Ariamelon/Ariamelon-Kicad-Master-Library/README.md

# Ariamelon Kicad Master Library
 Aria's Kicad Master Library
