Ariamelon/Ariamelon-Kicad-Master-Library/Ariamelon-Breakout-3D/Breakout_Raytac_MDBT50Q-U1MV2.STEP

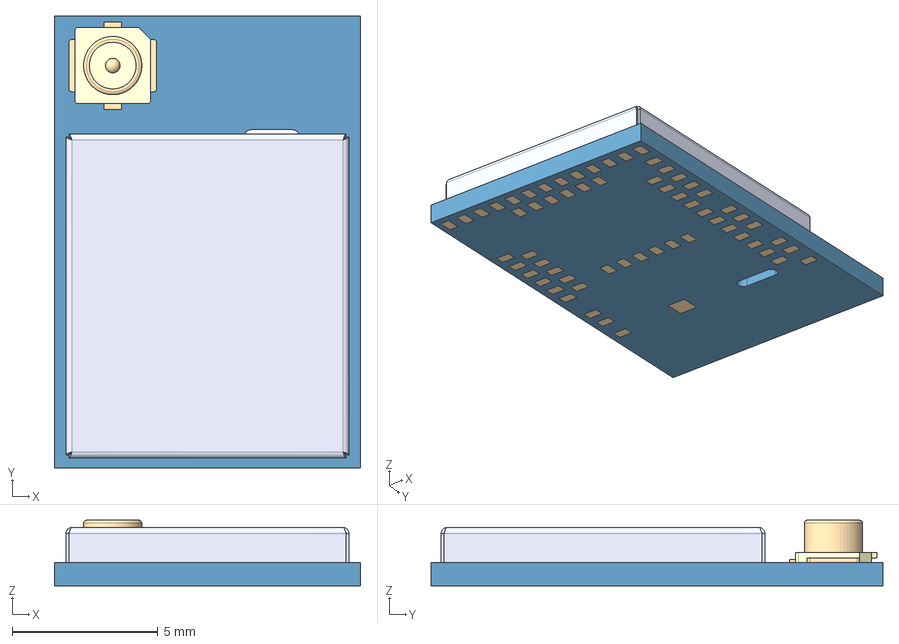
[picture p1: CAD file, 2023-08-23]
Ariamelon-Breakout-3D/Breakout_Raytac_MDBT50Q-U1MV2.STEP
10.5 x 15.5 x 2.25 mm
