Ariamelon/Ariamelon-Kicad-Master-Library/Ariamelon-Connector-3D/JST_SH_SM03B-SRSS-TB_1x03-1MP_P1.00mm_Horizontal.STEP

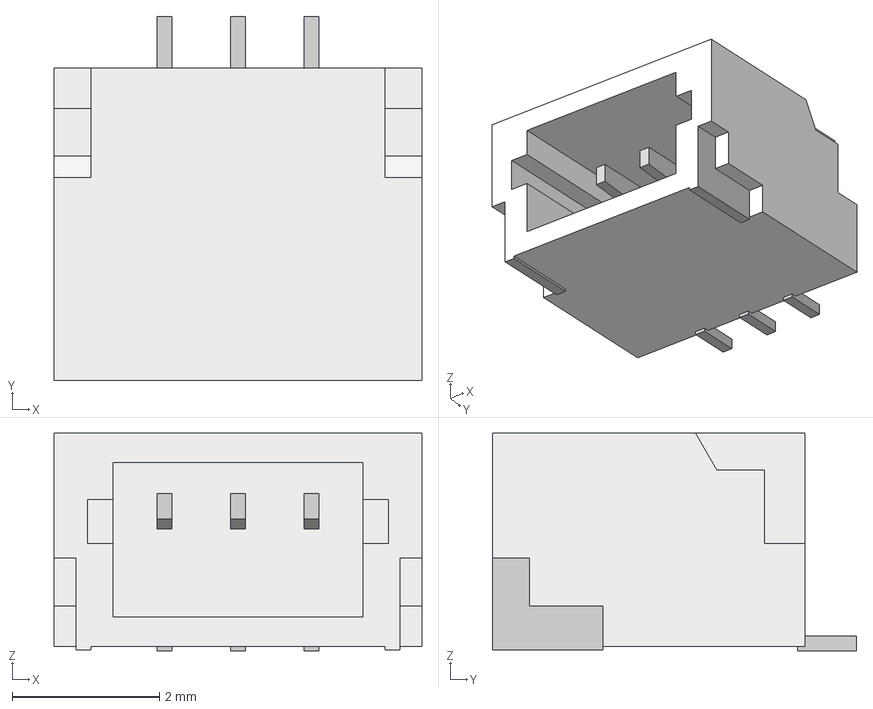
[picture p2: CAD file, 2023-08-23]
Ariamelon-Connector-3D/JST_SH_SM03B-SRSS-TB_1x03-1MP_P1.00mm_Horizontal.STEP
5.00 x 4.95 x 2.96 mm
