Ariamelon/Ariamelon-Kicad-Master-Library/Ariamelon-Device-3D/L_Murata_786J.STEP

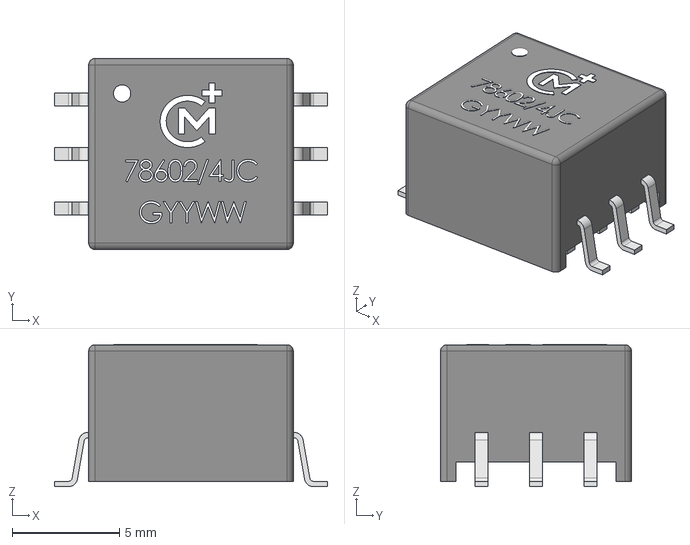
[picture p3: CAD file, 2023-09-18]
Ariamelon-Device-3D/L_Murata_786J.STEP
12.7 x 8.89 x 6.62 mm
