Ariamelon/Ariamelon-Kicad-Master-Library/Ariamelon-Misc-3D/Heatsink_CUI_HSE-B20380-040H.step

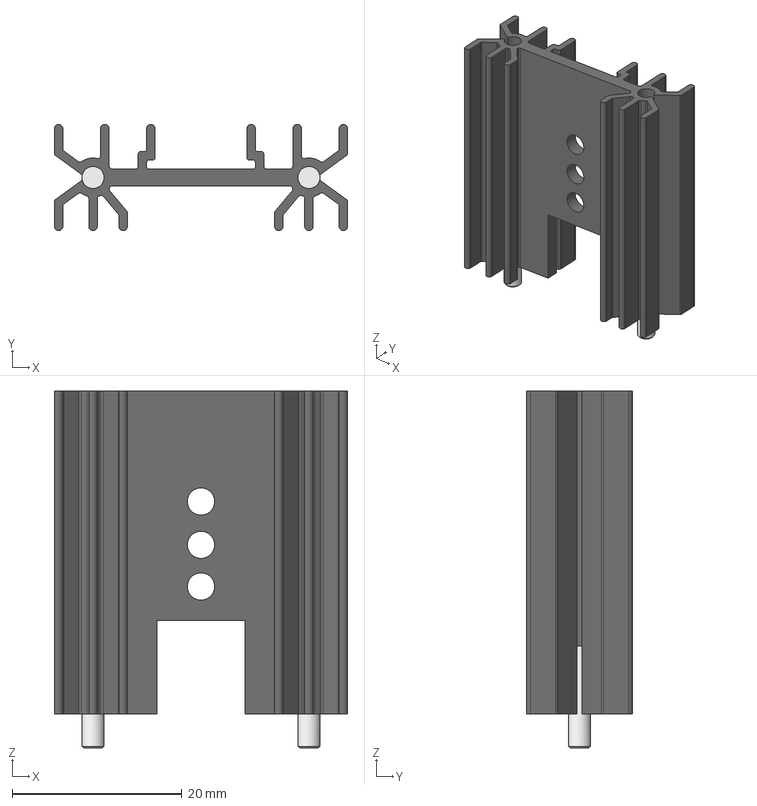
[picture p4: CAD file, 2023-09-23]
Ariamelon-Misc-3D/Heatsink_CUI_HSE-B20380-040H.step
34.5 x 12.5 x 42.0 mm
