Ariamelon/Ariamelon-Kicad-Master-Library/Ariamelon-RotaryEncoder-3D/RotaryEncoder_Alps_EC11E_Vertical_H20mm.step

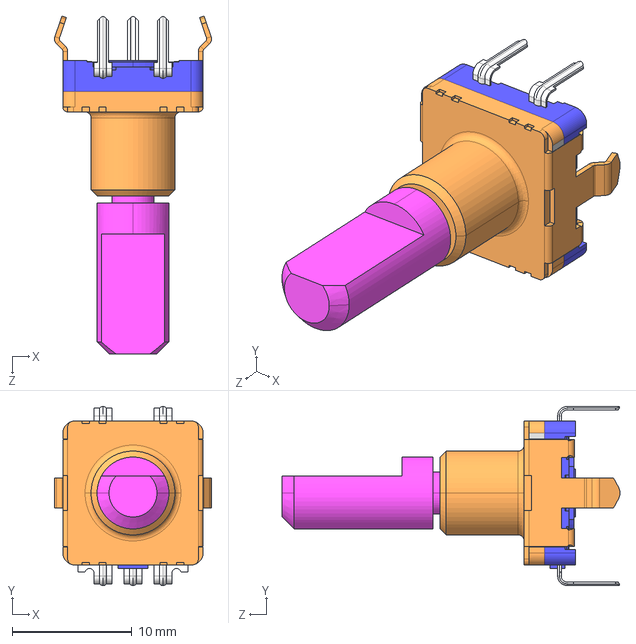
[picture p5: CAD file, 2023-08-24]
Ariamelon-RotaryEncoder-3D/RotaryEncoder_Alps_EC11E_Vertical_H20mm.step
13.1 x 15.0 x 28.2 mm
