Ariamelon/Ariamelon-Kicad-Master-Library/Ariamelon-Switch-3D/SW_KS33_Hotswap-Socket.step

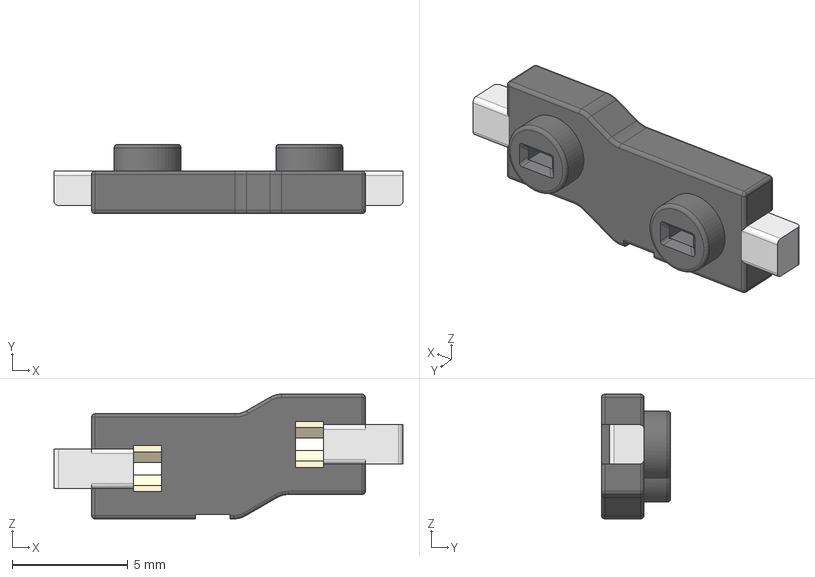
[picture p6: CAD file, 2024-10-16]
Ariamelon-Switch-3D/SW_KS33_Hotswap-Socket.step
15.1 x 3.00 x 5.40 mm
