Ariamelon/Ariamelon-Kicad-Master-Library/Ariamelon-Connector-3D/Hirose_CX70M-24P1.step

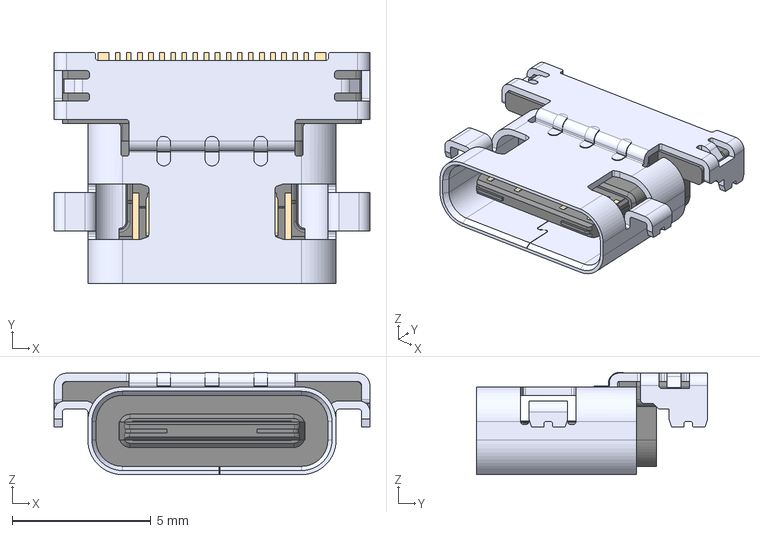
[picture p8: CAD file, 2023-08-23]
Ariamelon-Connector-3D/Hirose_CX70M-24P1.step
11.4 x 8.35 x 3.69 mm
