Ariamelon/Ariamelon-Kicad-Master-Library/Ariamelon-Device-3D/Fuse_1812_4532Metric.STEP

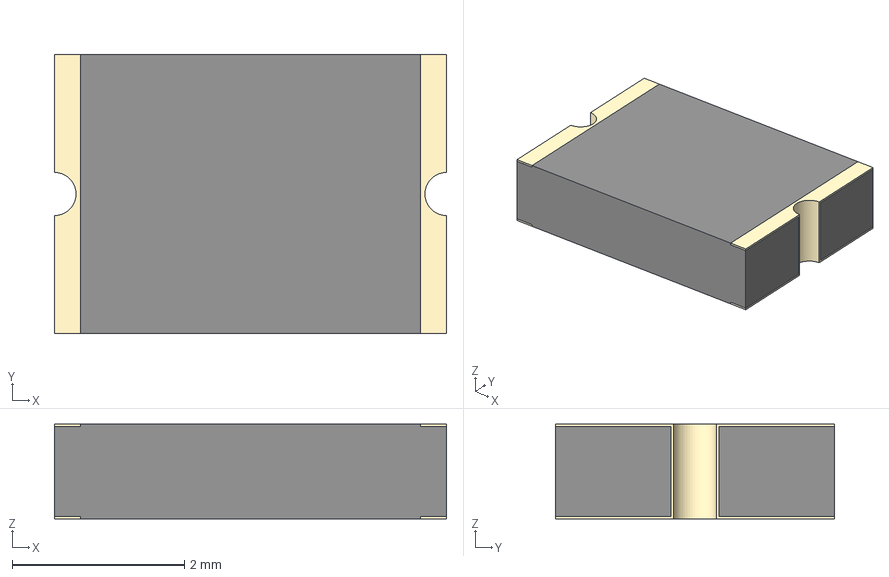
[picture p9: CAD file, 2023-09-18]
Ariamelon-Device-3D/Fuse_1812_4532Metric.STEP
4.55 x 3.24 x 1.10 mm
