Ariamelon/Ariamelon-Kicad-Master-Library/Ariamelon-Misc-3D/Heatsink_Fischer_SK104-STC-STIC_35x13mm_2xDrill2.5mm.step

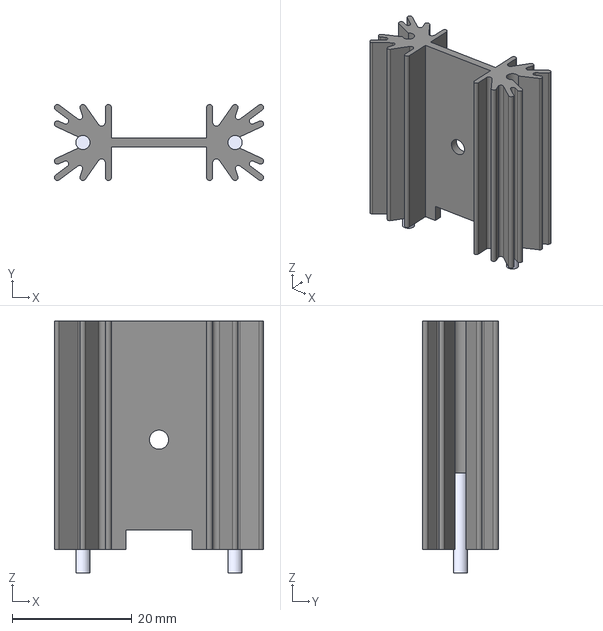
[picture p10: CAD file, 2023-09-22]
Ariamelon-Misc-3D/Heatsink_Fischer_SK104-STC-STIC_35x13mm_2xDrill2.5mm.step
34.9 x 12.7 x 42.1 mm
