Ariamelon/Ariamelon-Kicad-Master-Library/Ariamelon-Package-3D/SOP-8-Advance_5.0x6.0mm_P1.27mm.step

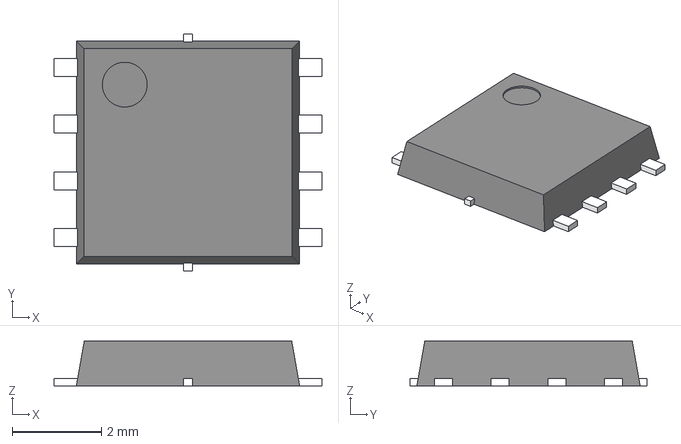
[picture p11: CAD file, 2023-10-16]
Ariamelon-Package-3D/SOP-8-Advance_5.0x6.0mm_P1.27mm.step
6.00 x 5.30 x 1.00 mm
