Ariamelon/Ariamelon-Kicad-Master-Library/Ariamelon-RotaryEncoder-3D/RotaryEncoder_Bourns_PER601-P117-N0015.stp

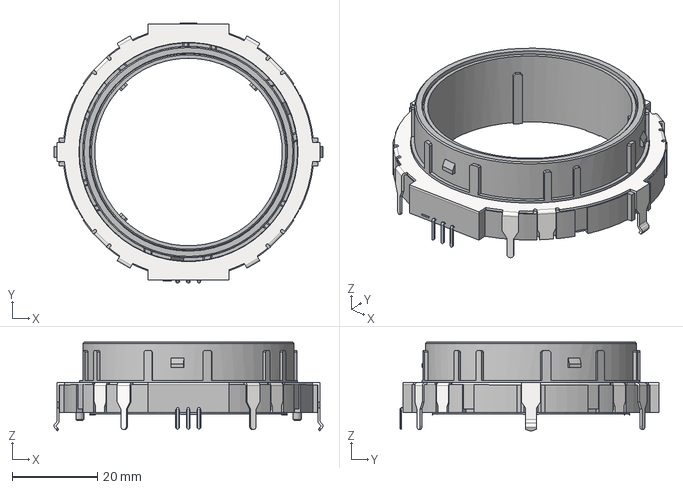
[picture p12: CAD file, 2023-08-23]
Ariamelon-RotaryEncoder-3D/RotaryEncoder_Bourns_PER601-P117-N0015.stp
63.1 x 61.1 x 20.8 mm
