Ariamelon/Ariamelon-Kicad-Master-Library/Ariamelon-Switch-3D/SW_Cap_Choc_LP_1U.step

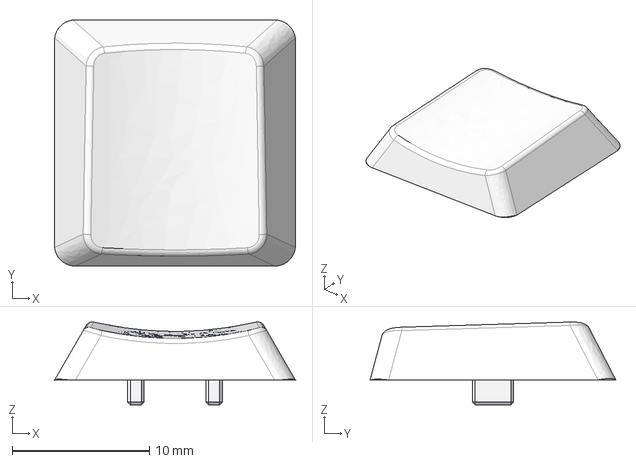
[picture p13: CAD file, 2023-08-27]
Ariamelon-Switch-3D/SW_Cap_Choc_LP_1U.step
17.5 x 17.9 x 6.03 mm
