Ariamelon/Ariamelon-Kicad-Master-Library/Ariamelon-Breakout-3D/Breakout_OLED_1.5_SSD1351_128x128.step

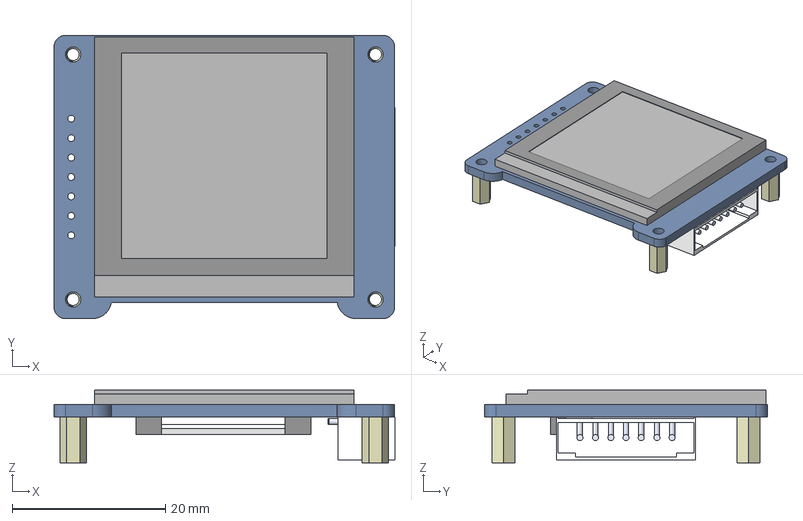
[picture p14: CAD file, 2023-08-23]
Ariamelon-Breakout-3D/Breakout_OLED_1.5_SSD1351_128x128.step
44.5 x 37.0 x 9.50 mm
M2XH6_COPPER-POST x 4
1_5INCH_OLED_RGB_PCBA
1_5INCH-RGB-OLED
