Ariamelon/Ariamelon-Kicad-Master-Library/Ariamelon-Connector-3D/Hirose_FH34SRJ-20S-0.5SH(50).step

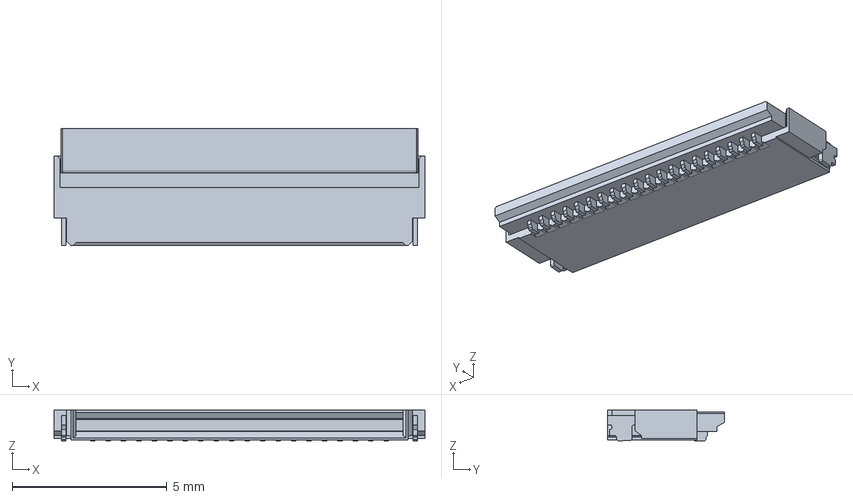
[picture p15: CAD file, 2023-08-23]
Ariamelon-Connector-3D/Hirose_FH34SRJ-20S-0.5SH(50).step
12.0 x 3.80 x 1.00 mm
