Ariamelon/Ariamelon-Kicad-Master-Library/Ariamelon-Device-3D/Crystal_SMD_2012-2Pin_2.0x1.2mm.STEP

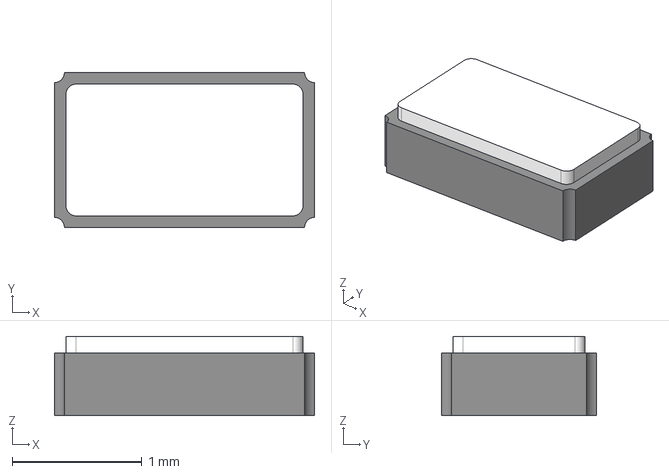
[picture p16: CAD file, 2023-08-23]
Ariamelon-Device-3D/Crystal_SMD_2012-2Pin_2.0x1.2mm.STEP
2.01 x 1.19 x 0.612 mm
