Ariamelon/Ariamelon-Kicad-Master-Library/Ariamelon-Misc-3D/Relay_Panasonic_CB1-P-12V.step

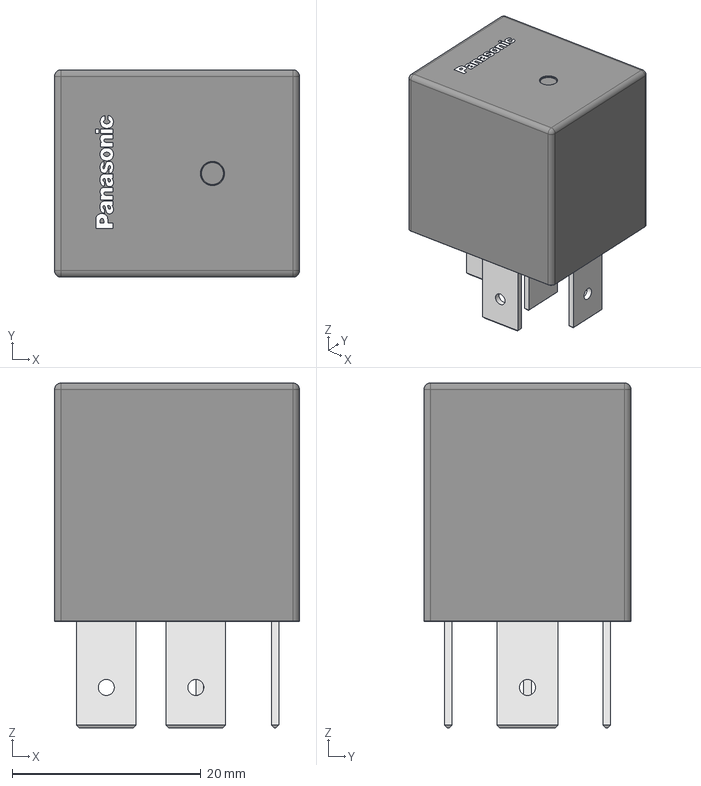
[picture p17: CAD file, 2023-08-23]
Ariamelon-Misc-3D/Relay_Panasonic_CB1-P-12V.step
26.0 x 22.0 x 36.6 mm
terminals
logo
