Ariamelon/Ariamelon-Kicad-Master-Library/Ariamelon-Package-3D/USON-8-1EP_3x2mm_P0.5mm_EP1.6x0.2mm.stp

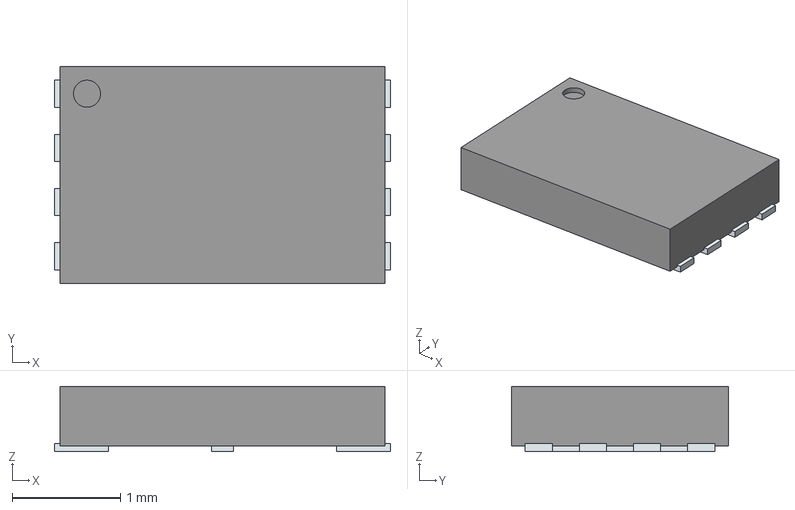
[picture p18: CAD file, 2023-08-23]
Ariamelon-Package-3D/USON-8-1EP_3x2mm_P0.5mm_EP1.6x0.2mm.stp
3.10 x 2.00 x 0.6 mm
ThermalPin
PinsArrayLR
