Ariamelon/Ariamelon-Kicad-Master-Library/Ariamelon-Switch-3D/SW_Cherry_MX_PCB.STEP

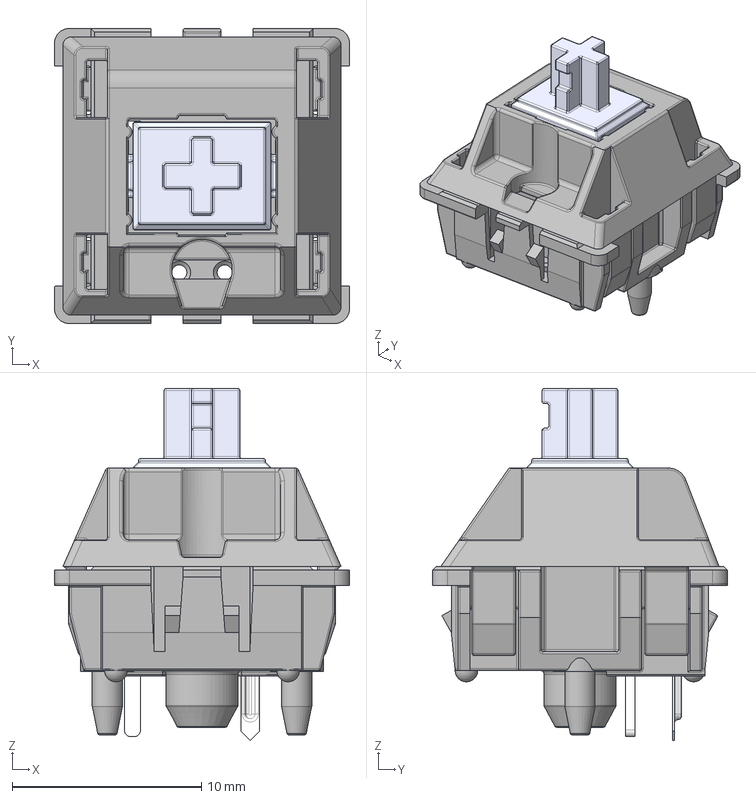
[picture p20: CAD file, 2023-08-23]
Ariamelon-Switch-3D/SW_Cherry_MX_PCB.STEP
15.6 x 15.6 x 18.6 mm
Pins
Top Housing
Stem
Bottom Housing
