Ariamelon/Ariamelon-Kicad-Master-Library/Ariamelon-Breakout-3D/Breakout_Raytac_MDBT50Q-1MV2.step

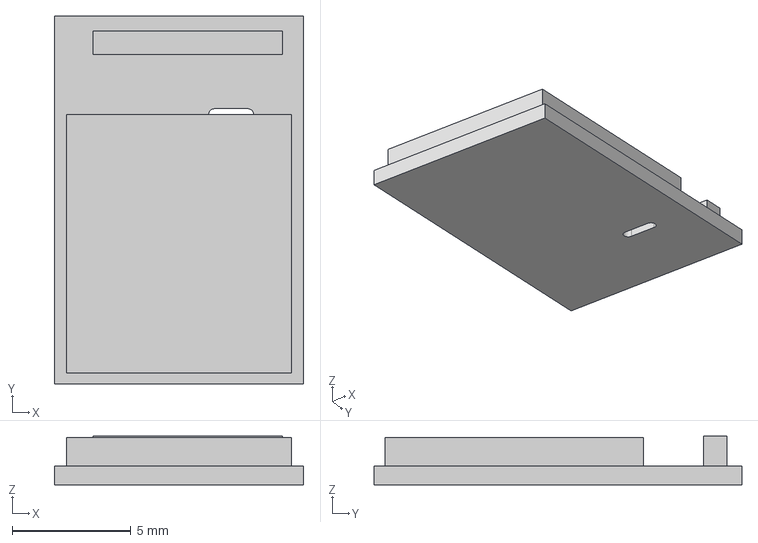
[picture p21: CAD file, 2023-08-23]
Ariamelon-Breakout-3D/Breakout_Raytac_MDBT50Q-1MV2.step
10.5 x 15.5 x 2.05 mm
