Ariamelon/Ariamelon-Kicad-Master-Library/Ariamelon-Device-3D/L_Murata_LQH3NPZ.step

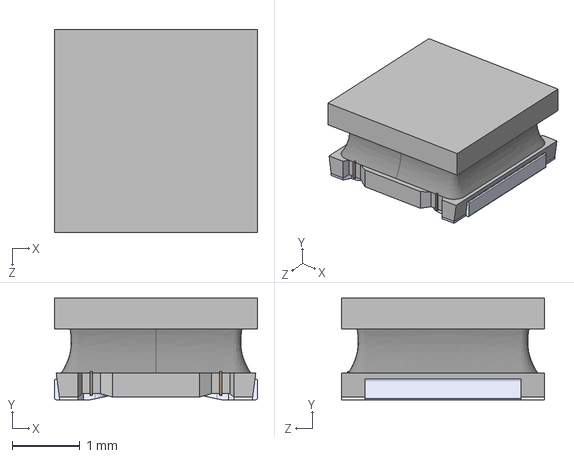
[picture p23: CAD file, 2023-08-23]
Ariamelon-Device-3D/L_Murata_LQH3NPZ.step
3.00 x 1.50 x 3.00 mm
