Ariamelon/Ariamelon-Kicad-Master-Library/Ariamelon-Package-3D/PixArt_PMW3360DM-T2QU.step

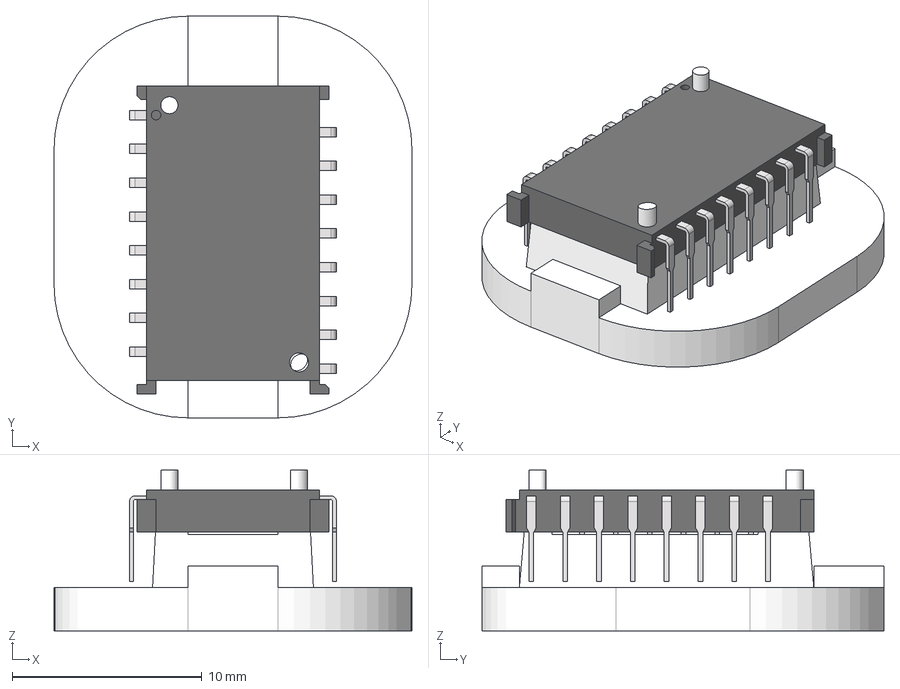
[picture p24: CAD file, 2023-08-23]
Ariamelon-Package-3D/PixArt_PMW3360DM-T2QU.step
18.9 x 21.1 x 8.46 mm
Lead x 8
Lead(Mirror) x 8
Lens
