Ariamelon/Ariamelon-Kicad-Master-Library/Ariamelon-RotaryEncoder-3D/RotaryEncoder_Panasonic_EVQVVD00203B.step

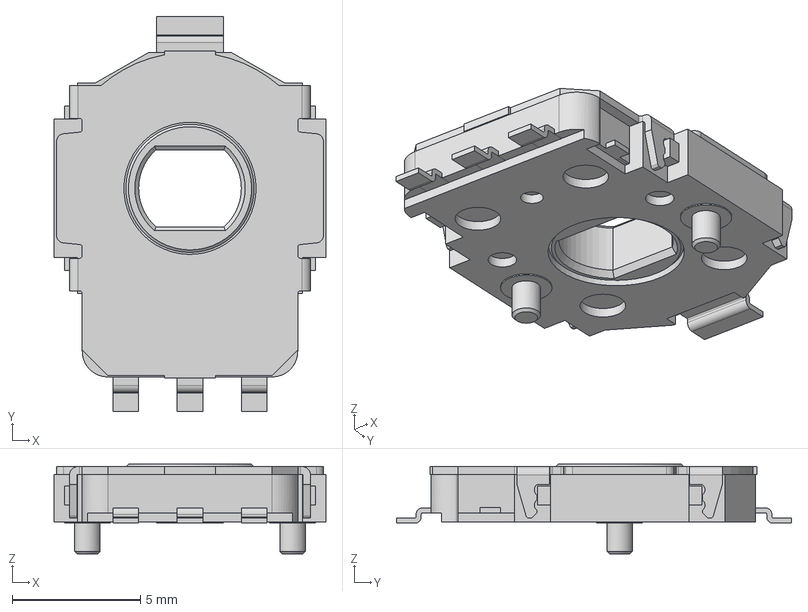
[picture p25: CAD file, 2023-08-23]
Ariamelon-RotaryEncoder-3D/RotaryEncoder_Panasonic_EVQVVD00203B.step
10.6 x 15.4 x 3.50 mm
