Ariamelon/Ariamelon-Kicad-Master-Library/Ariamelon-Switch-3D/SW_Panasonic_EVQPUL_EVQPUC.step

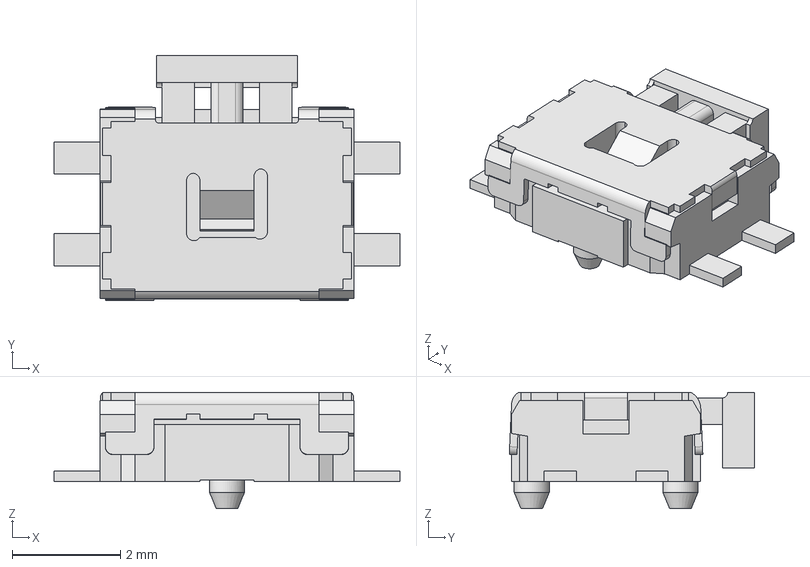
[picture p26: CAD file, 2023-08-23]
Ariamelon-Switch-3D/SW_Panasonic_EVQPUL_EVQPUC.step
6.40 x 4.54 x 2.15 mm
