Ariamelon/Ariamelon-Kicad-Master-Library/Ariamelon-Breakout-3D/Breakout_Ebyte_E73-2G4M08S1C.step

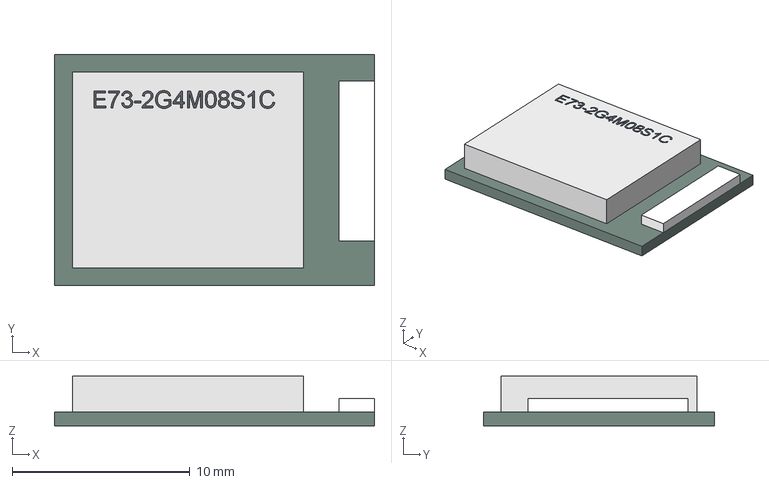
[picture p27: CAD file, 2023-08-23]
Ariamelon-Breakout-3D/Breakout_Ebyte_E73-2G4M08S1C.step
18.0 x 13.0 x 2.81 mm
