Ariamelon/Ariamelon-Kicad-Master-Library/Ariamelon-Connector-3D/HRO_TYPE-C-31-M-14.step

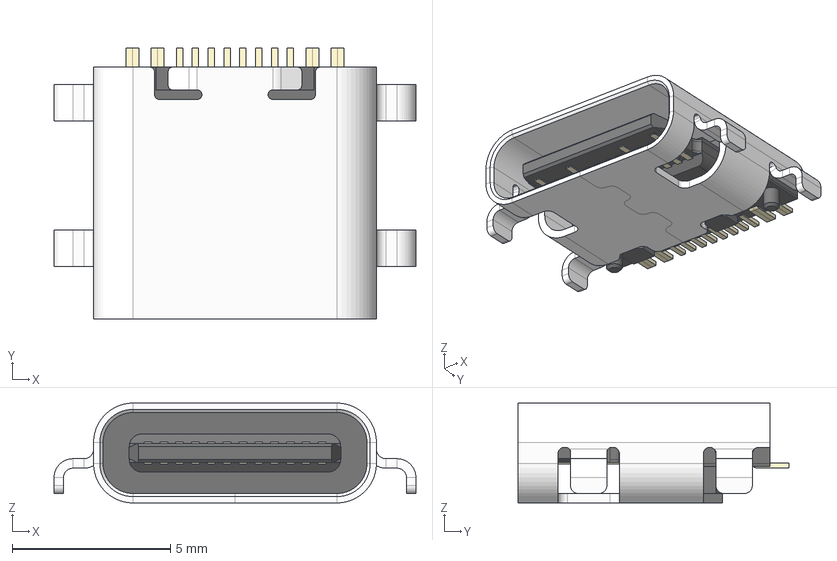
[picture p28: CAD file, 2023-08-23]
Ariamelon-Connector-3D/HRO_TYPE-C-31-M-14.step
11.5 x 8.56 x 3.16 mm
Shroud
Plastic Body & Connector
