Ariamelon/Ariamelon-Kicad-Master-Library/Ariamelon-Device-3D/L_Murata_DFE201610P.STEP

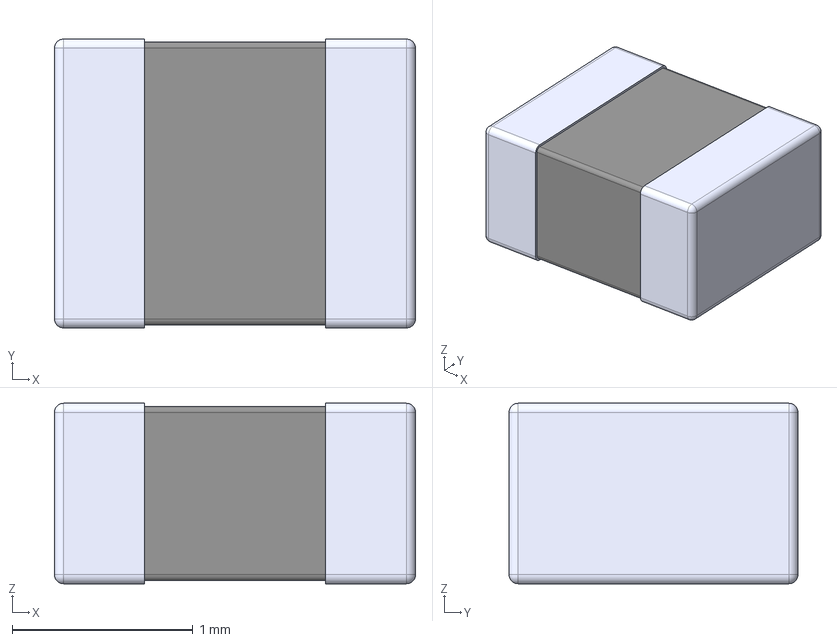
[picture p29: CAD file, 2023-08-23]
Ariamelon-Device-3D/L_Murata_DFE201610P.STEP
2.00 x 1.60 x 1.00 mm
