Ariamelon/Ariamelon-Kicad-Master-Library/Ariamelon-Package-3D/Diodes_PowerDI3333-8.STEP

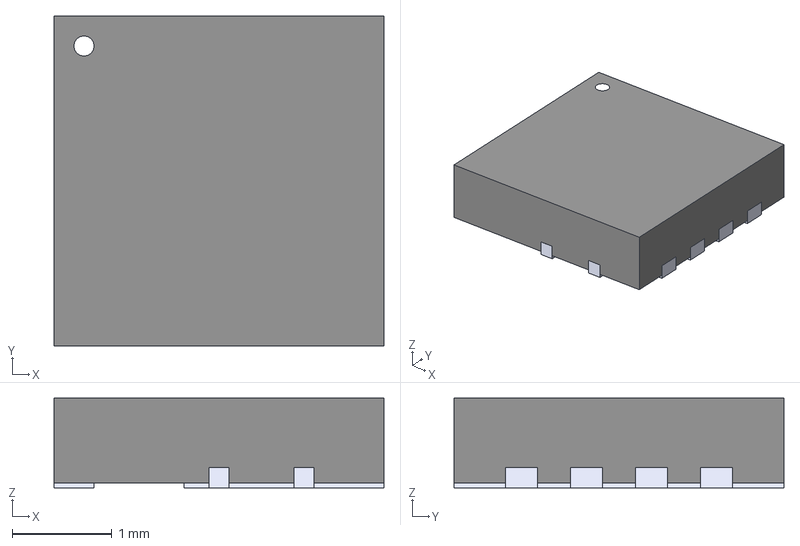
[picture p30: CAD file, 2023-08-23]
Ariamelon-Package-3D/Diodes_PowerDI3333-8.STEP
3.30 x 3.30 x 0.9 mm
