Ariamelon/Ariamelon-Kicad-Master-Library/Ariamelon-RotaryEncoder-3D/RotaryEncoder_Alps_EC10E-9MM.step

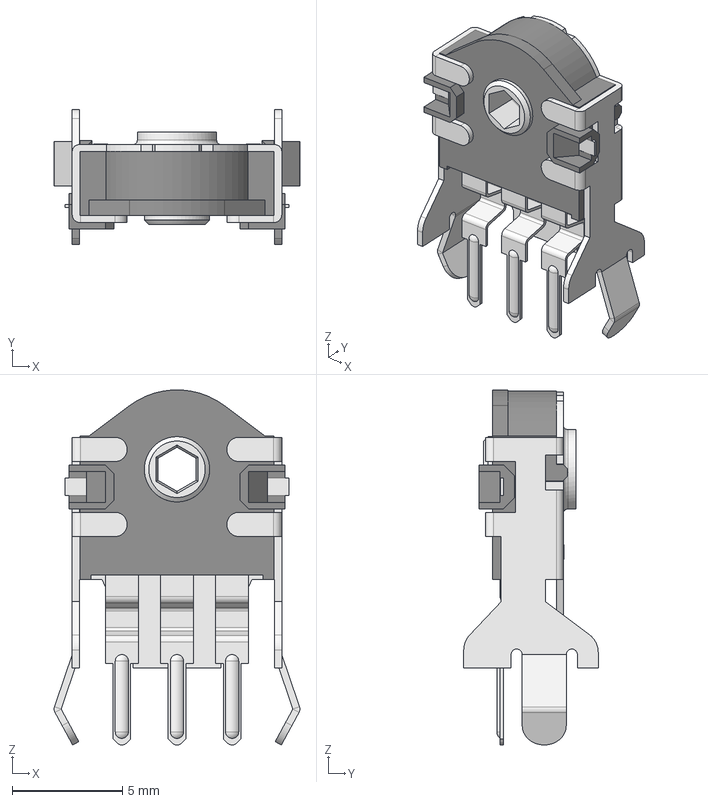
[picture p31: CAD file, 2023-08-23]
Ariamelon-RotaryEncoder-3D/RotaryEncoder_Alps_EC10E-9MM.step
11.1 x 6.10 x 16.1 mm
