Ariamelon/Ariamelon-Kicad-Master-Library/Ariamelon-Switch-3D/SW_Kailh_Hotswap-Socket_MX.step

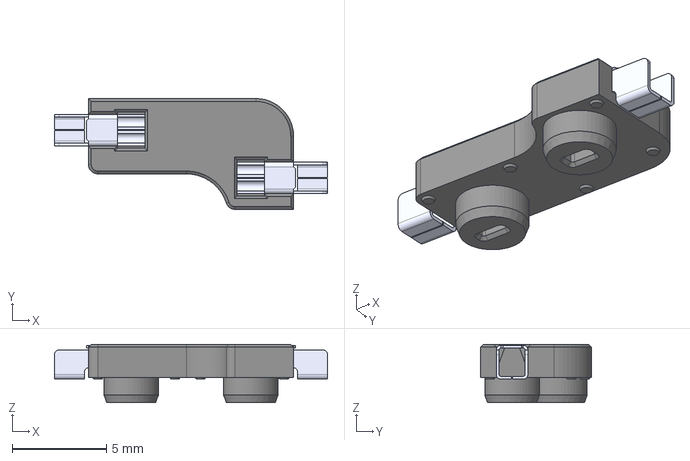
[picture p32: CAD file, 2023-08-23]
Ariamelon-Switch-3D/SW_Kailh_Hotswap-Socket_MX.step
14.5 x 5.89 x 3.10 mm
