Ariamelon/Ariamelon-Kicad-Master-Library/Ariamelon-Connector-3D/GCT_USB4120-03-C-REVA.step

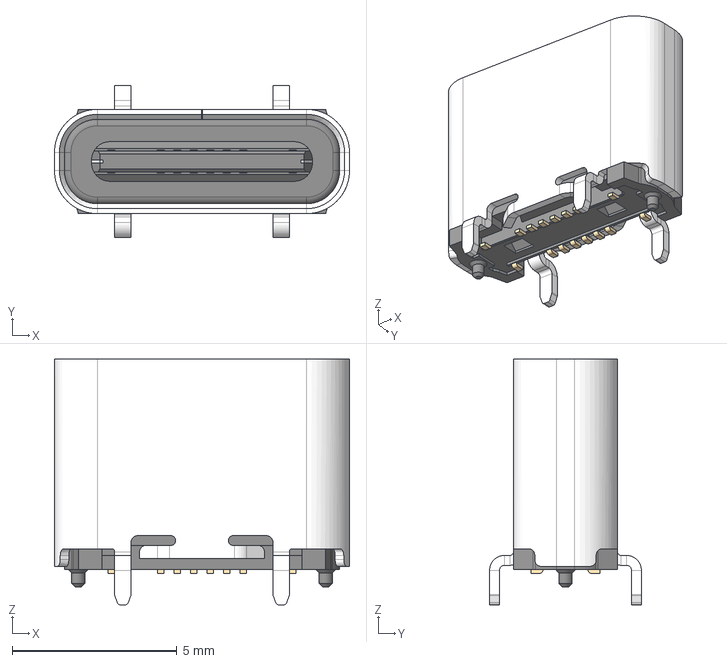
[picture p33: CAD file, 2023-08-23]
Ariamelon-Connector-3D/GCT_USB4120-03-C-REVA.step
8.94 x 4.60 x 7.45 mm
