Ariamelon/Ariamelon-Kicad-Master-Library/Ariamelon-Device-3D/Crystal_SMD_3215-2Pin_3.2x1.5mm.STEP

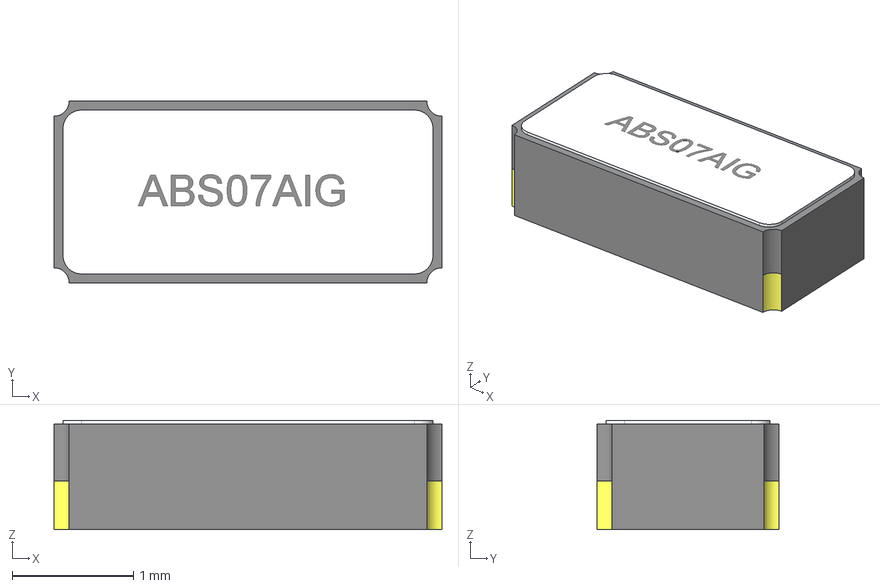
[picture p34: CAD file, 2023-08-23]
Ariamelon-Device-3D/Crystal_SMD_3215-2Pin_3.2x1.5mm.STEP
3.20 x 1.50 x 0.901 mm
