Ariamelon/Ariamelon-Kicad-Master-Library/Ariamelon-Package-3D/Texas_R-PUQFN-N10.step

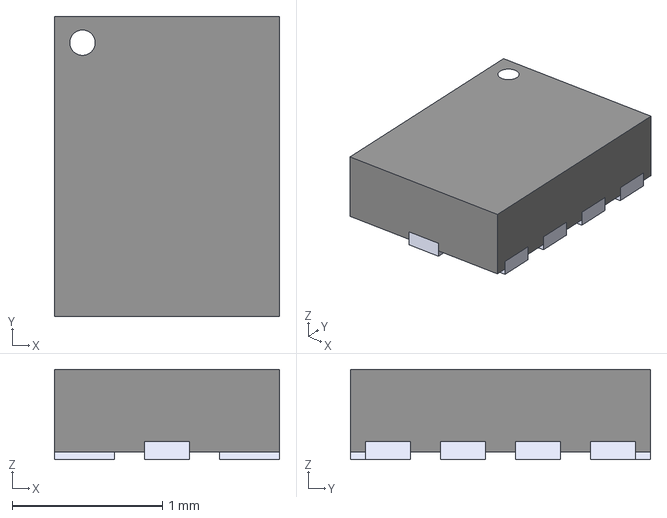
[picture p35: CAD file, 2023-08-23]
Ariamelon-Package-3D/Texas_R-PUQFN-N10.step
1.50 x 2.00 x 0.6 mm
