Ariamelon/Ariamelon-Kicad-Master-Library/Ariamelon-RotaryEncoder-3D/RotaryEncoder_Alps_EC10E.step

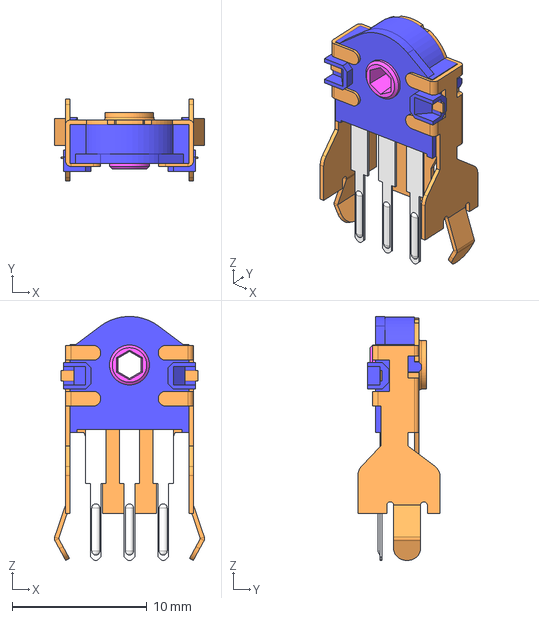
[picture p36: CAD file, 2023-08-23]
Ariamelon-RotaryEncoder-3D/RotaryEncoder_Alps_EC10E.step
11.1 x 6.10 x 18.1 mm
