Ariamelon/Ariamelon-Kicad-Master-Library/Ariamelon-Switch-3D/SW_Kailh_Choc.step

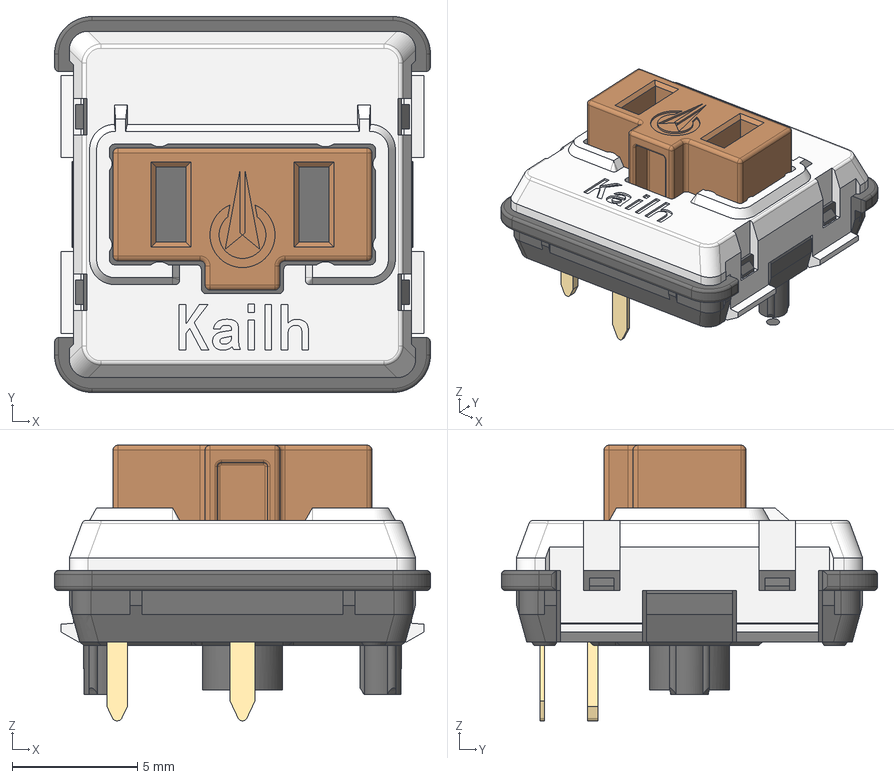
[picture p37: CAD file, 2023-08-23]
Ariamelon-Switch-3D/SW_Kailh_Choc.step
15.0 x 15.0 x 11.0 mm
