Ariamelon/Ariamelon-Kicad-Master-Library/Ariamelon-Device-3D/Crystal_SMD_2016-4Pin_2.0x1.6mm.STEP

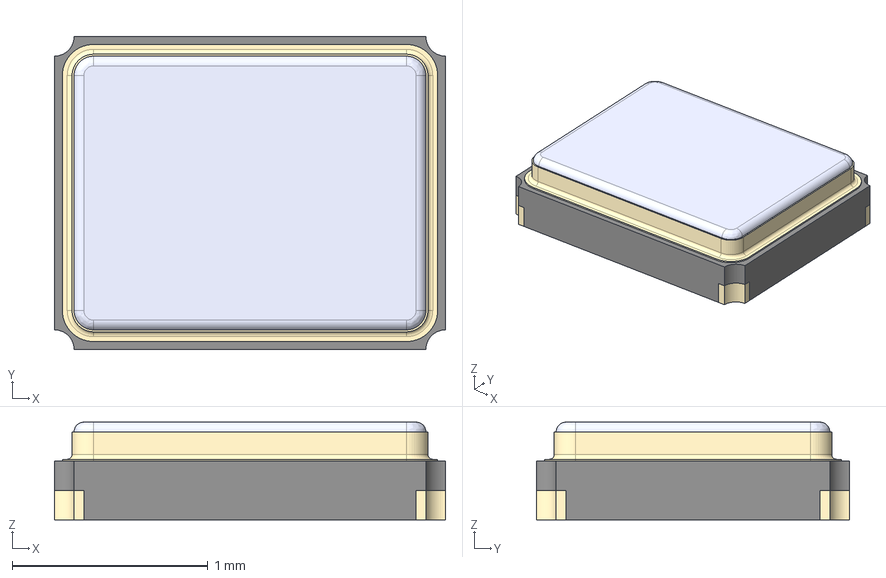
[picture p39: CAD file, 2023-08-23]
Ariamelon-Device-3D/Crystal_SMD_2016-4Pin_2.0x1.6mm.STEP
2.00 x 1.60 x 0.5 mm
