Ariamelon/Ariamelon-Kicad-Master-Library/Ariamelon-Package-3D/WSON-8-1EP_2x2mm_P0.5mm_EP0.9x1.6mm.stp

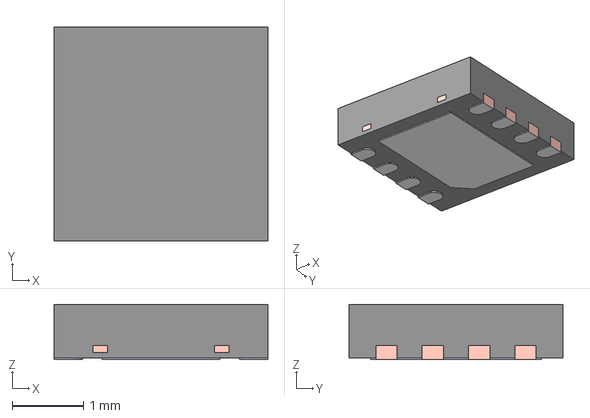
[picture p40: CAD file, 2023-08-23]
Ariamelon-Package-3D/WSON-8-1EP_2x2mm_P0.5mm_EP0.9x1.6mm.stp
3.00 x 3.00 x 0.775 mm
BODY-SON
FRAME-DRB0008B
