Ariamelon/Ariamelon-Kicad-Master-Library/Ariamelon-Switch-3D/SW_Cap_DSA_2.75U.step

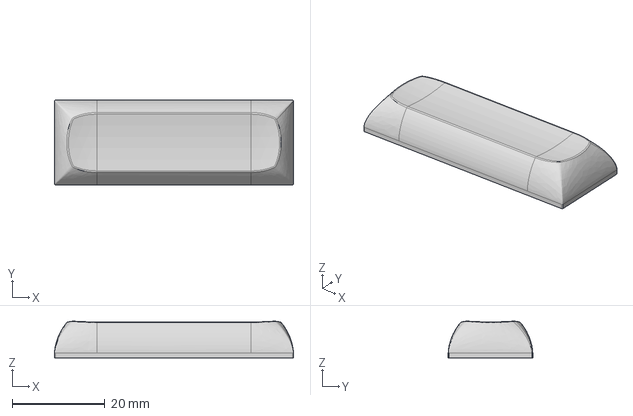
[picture p41: CAD file, 2023-08-23]
Ariamelon-Switch-3D/SW_Cap_DSA_2.75U.step
51.5 x 18.2 x 7.91 mm
