Ariamelon/Ariamelon-Kicad-Master-Library/Ariamelon-Connector-3D/JST_SH_SM02B-SRSS-TB_1x02-1MP_P1.00mm_Horizontal.STEP

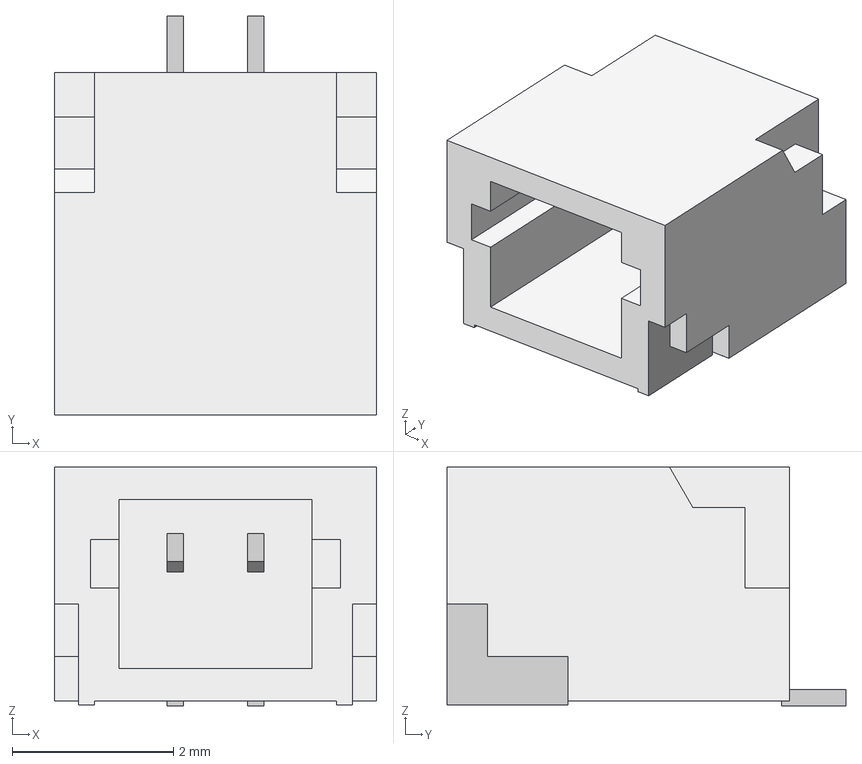
[picture p42: CAD file, 2023-08-23]
Ariamelon-Connector-3D/JST_SH_SM02B-SRSS-TB_1x02-1MP_P1.00mm_Horizontal.STEP
4.00 x 4.95 x 2.96 mm
