Ariamelon/Ariamelon-Kicad-Master-Library/Ariamelon-Device-3D/LED_OPSCO_SK6812MINI-E.step

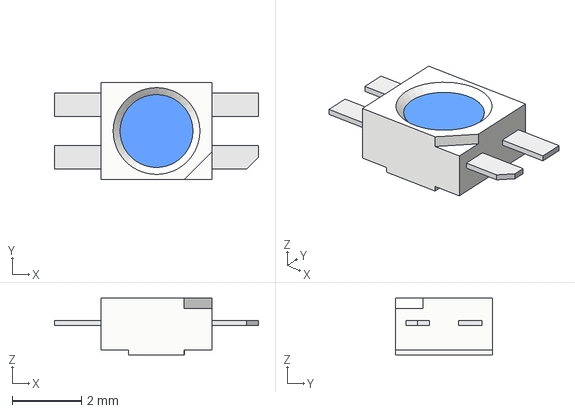
[picture p43: CAD file, 2023-08-23]
Ariamelon-Device-3D/LED_OPSCO_SK6812MINI-E.step
5.88 x 2.80 x 1.63 mm
