Ariamelon/Ariamelon-Kicad-Master-Library/Ariamelon-Package-3D/Texas_X2QFN-12_1.6x1.6mm_P0.4mm.stp

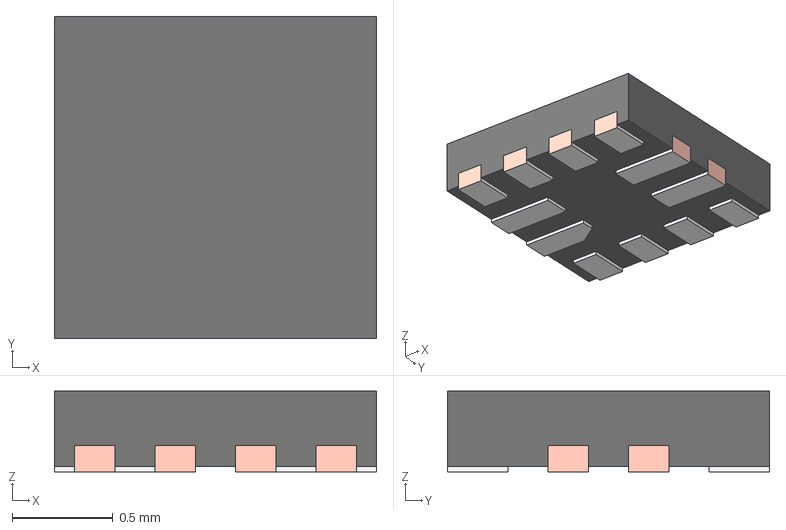
[picture p44: CAD file, 2023-08-23]
Ariamelon-Package-3D/Texas_X2QFN-12_1.6x1.6mm_P0.4mm.stp
1.60 x 1.60 x 0.4 mm
FRAME-RWB0012A
BODY-QFN
