Ariamelon/Ariamelon-Kicad-Master-Library/Ariamelon-RotaryEncoder-3D/RotaryEncoder_Mitsumi_SIQ-02FVS3.STEP

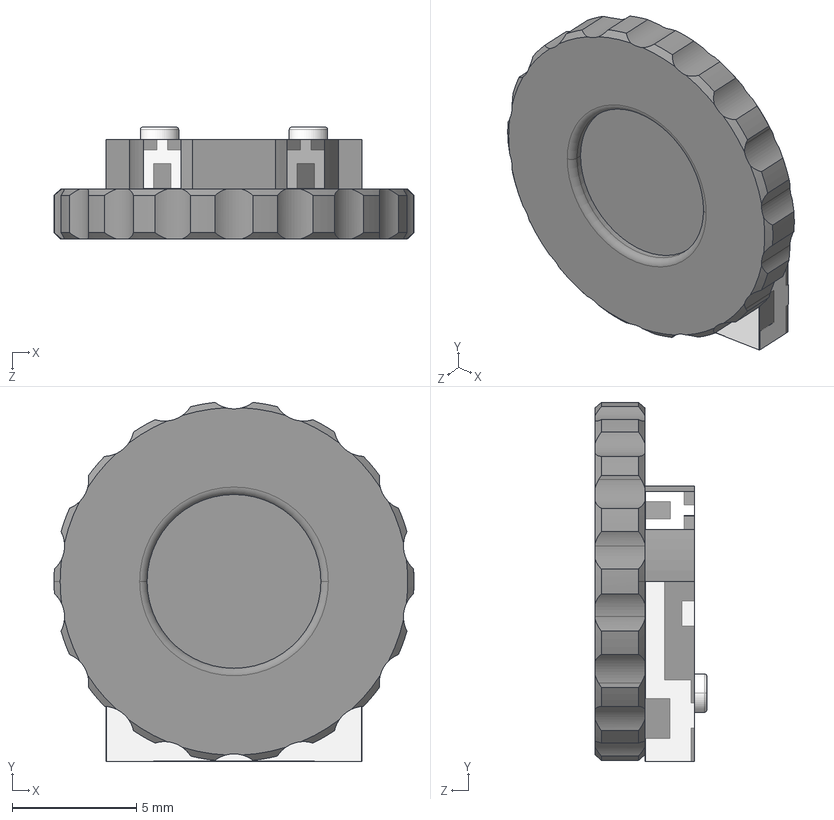
[picture p45: CAD file, 2023-08-23]
Ariamelon-RotaryEncoder-3D/RotaryEncoder_Mitsumi_SIQ-02FVS3.STEP
14.5 x 14.5 x 4.50 mm
