Ariamelon/Ariamelon-Kicad-Master-Library/Ariamelon-Switch-3D/SW_Cap_DSA_1U.step

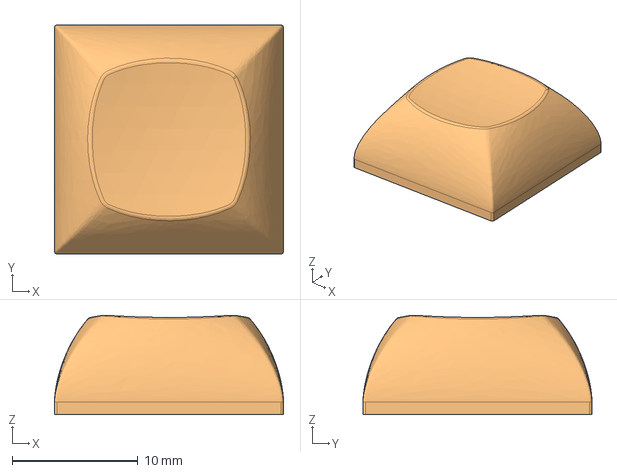
[picture p46: CAD file, 2023-08-23]
Ariamelon-Switch-3D/SW_Cap_DSA_1U.step
18.2 x 18.2 x 7.91 mm
