Ariamelon/Ariamelon-Kicad-Master-Library/Ariamelon-Connector-3D/Hirose_FH12-30S-0.5SH_1x30-1MP_P0.50mm_Horizontal.step

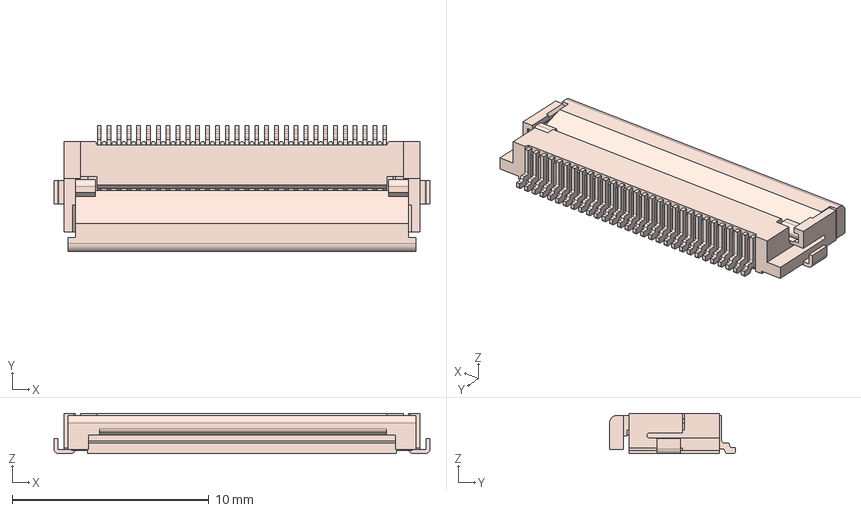
[picture p47: CAD file, 2023-08-23]
Ariamelon-Connector-3D/Hirose_FH12-30S-0.5SH_1x30-1MP_P0.50mm_Horizontal.step
19.1 x 6.40 x 2.05 mm
