Ariamelon/Ariamelon-Kicad-Master-Library/Ariamelon-Device-3D/LED_WS2812-2020.STEP

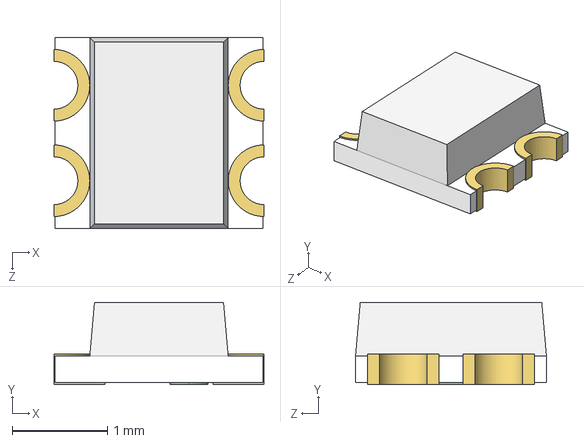
[picture p48: CAD file, 2023-08-23]
Ariamelon-Device-3D/LED_WS2812-2020.STEP
2.20 x 0.86 x 2.00 mm
