Ariamelon/Ariamelon-Kicad-Master-Library/Ariamelon-Package-3D/PixArt_PMW3360DM-T2QU_Lens.step

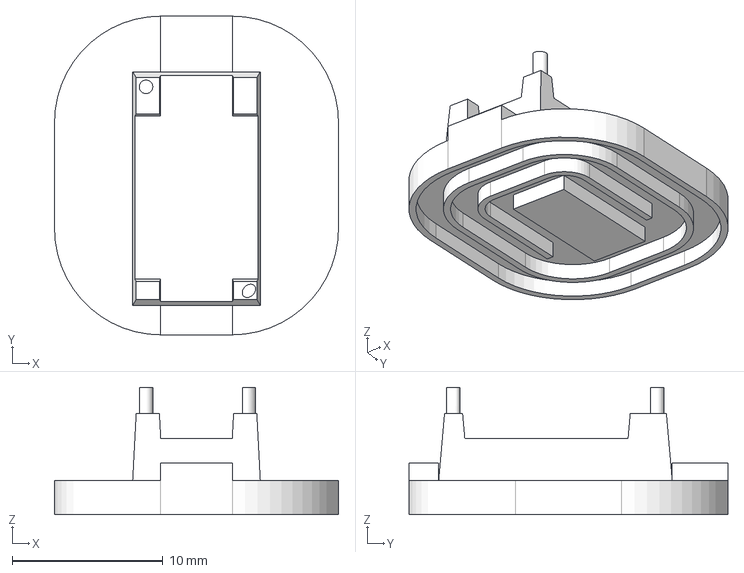
[picture p49: CAD file, 2023-08-23]
Ariamelon-Package-3D/PixArt_PMW3360DM-T2QU_Lens.step
18.9 x 21.1 x 8.46 mm
