Ariamelon/Ariamelon-Kicad-Master-Library/Ariamelon-RotaryEncoder-3D/RotaryEncoder_Bourns_PER561-P115-N0015.stp

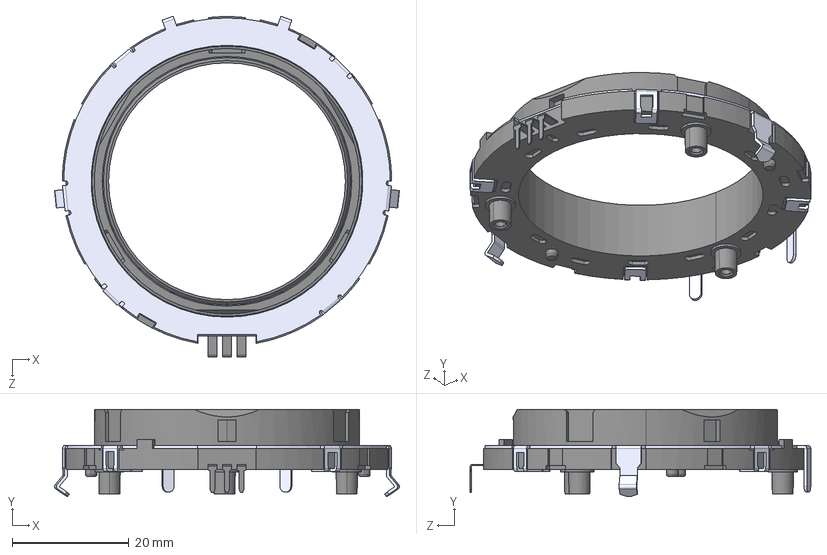
[picture p50: CAD file, 2023-08-23]
Ariamelon-RotaryEncoder-3D/RotaryEncoder_Bourns_PER561-P115-N0015.stp
59.2 x 15.0 x 58.4 mm
