Ariamelon/Ariamelon-Kicad-Master-Library/Ariamelon-Switch-3D/SW_SPST_PTS645_7mm.step

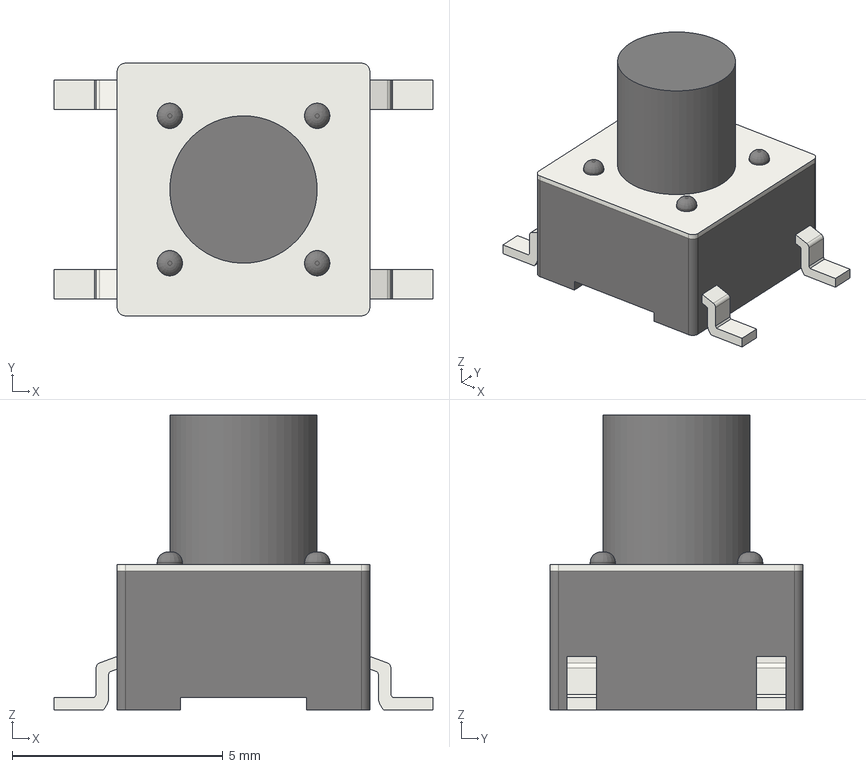
[picture p51: CAD file, 2023-08-23]
Ariamelon-Switch-3D/SW_SPST_PTS645_7mm.step
9.00 x 6.00 x 7.00 mm
