Ariamelon/Ariamelon-Kicad-Master-Library/Ariamelon-Device-3D/LED_Lite-On_LTST-S310_3x1.5mm_Horizontal.STEP

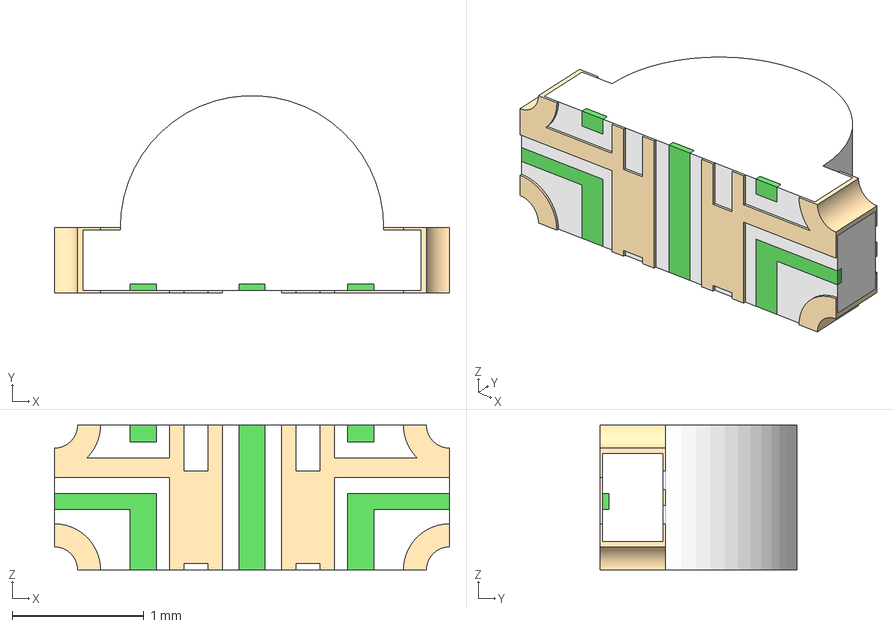
[picture p53: CAD file, 2023-08-23]
Ariamelon-Device-3D/LED_Lite-On_LTST-S310_3x1.5mm_Horizontal.STEP
3.00 x 1.50 x 1.10 mm
