Ariamelon/Ariamelon-Kicad-Master-Library/Ariamelon-Switch-3D/SW_SPDT_CK-JS102011SAQN.step

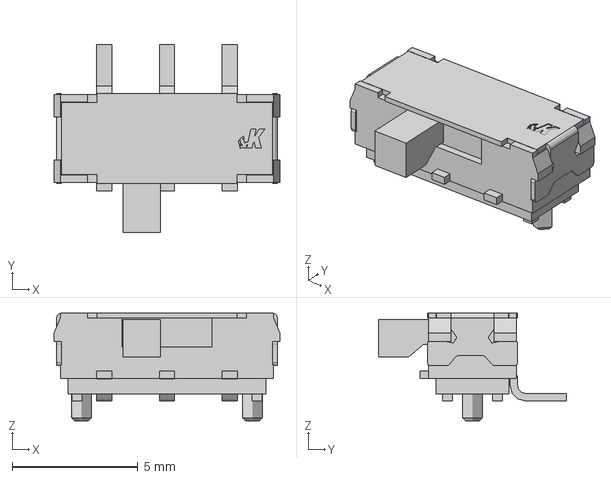
[picture p54: CAD file, 2023-08-23]
Ariamelon-Switch-3D/SW_SPDT_CK-JS102011SAQN.step
9.00 x 7.50 x 4.30 mm
