Ariamelon/Ariamelon-Kicad-Master-Library/Ariamelon-Connector-3D/JST_SH_SM08B-SRSS-TB_1x08-1MP_P1.00mm_Horizontal.STEP

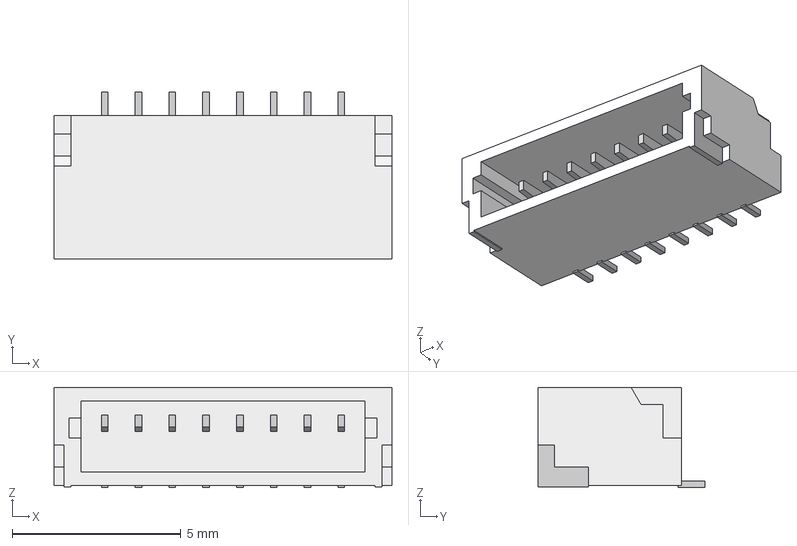
[picture p55: CAD file, 2023-08-23]
Ariamelon-Connector-3D/JST_SH_SM08B-SRSS-TB_1x08-1MP_P1.00mm_Horizontal.STEP
10.0 x 4.95 x 2.96 mm
