Ariamelon/Ariamelon-Kicad-Master-Library/Ariamelon-Switch-3D/SW_Alps_SKRTLA.step

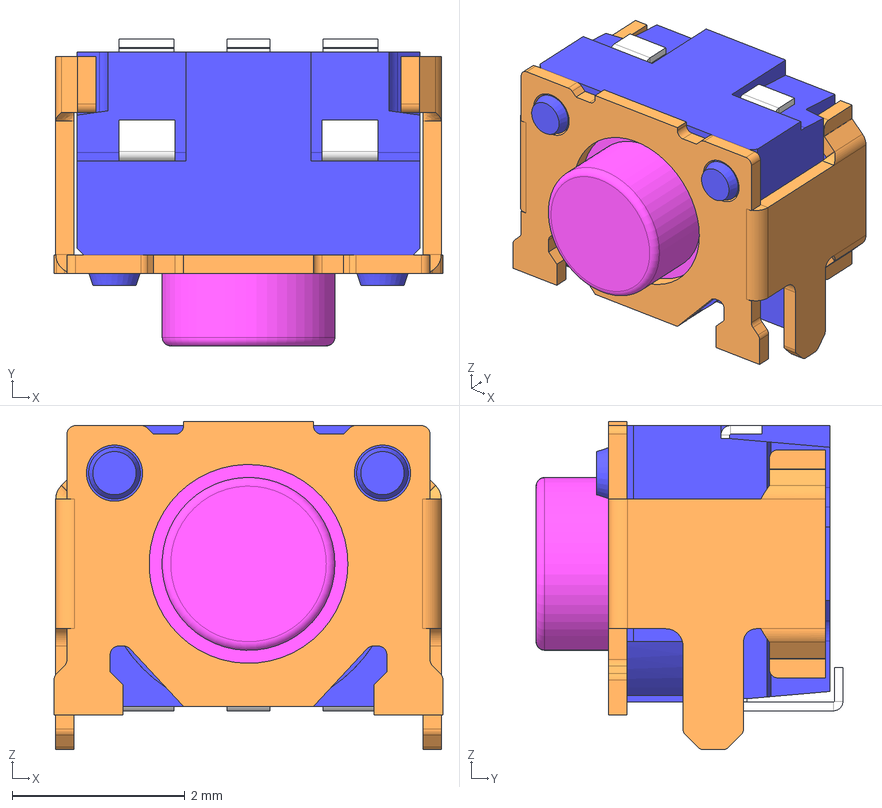
[picture p56: CAD file, 2023-08-23]
Ariamelon-Switch-3D/SW_Alps_SKRTLA.step
4.50 x 3.55 x 3.80 mm
