Ariamelon/Ariamelon-Kicad-Master-Library/Ariamelon-Switch-3D/SW_SPST_PTS645_9.5mm.step

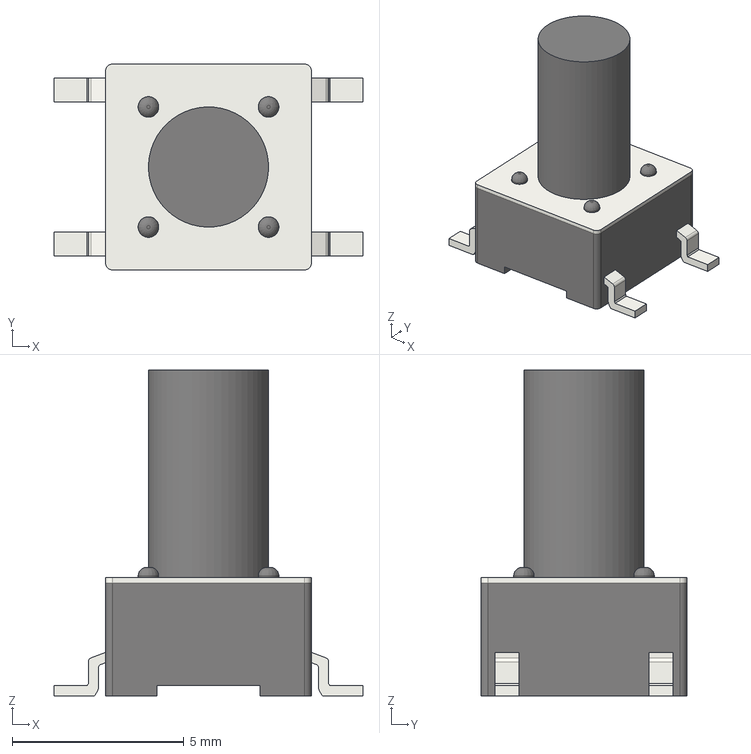
[picture p58: CAD file, 2023-08-23]
Ariamelon-Switch-3D/SW_SPST_PTS645_9.5mm.step
9.00 x 6.00 x 9.50 mm
