Ariamelon/Ariamelon-Kicad-Master-Library/Ariamelon-Connector-3D/Hirose_FH12-12S-0.5SH_1x12-1MP_P0.50mm_Horizontal_Flippable.step

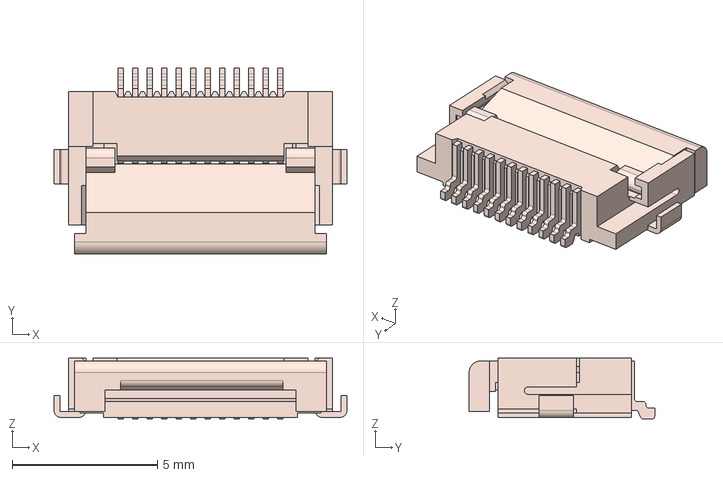
[picture p59: CAD file, 2023-08-23]
Ariamelon-Connector-3D/Hirose_FH12-12S-0.5SH_1x12-1MP_P0.50mm_Horizontal_Flippable.step
10.1 x 6.40 x 2.10 mm
