Ariamelon/Ariamelon-Kicad-Master-Library/Ariamelon-Switch-3D/SW_Cap_DSA_2.25U.step

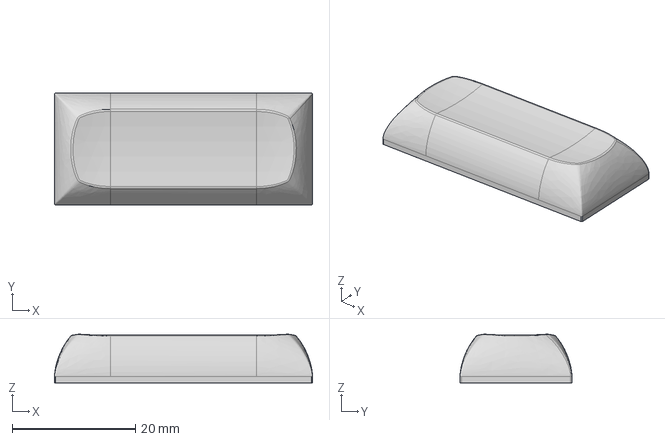
[picture p60: CAD file, 2023-08-23]
Ariamelon-Switch-3D/SW_Cap_DSA_2.25U.step
42.0 x 18.2 x 7.91 mm
