Ariamelon/Ariamelon-Kicad-Master-Library/Ariamelon-Connector-3D/HRO_TYPE-C-31-M-13C.step

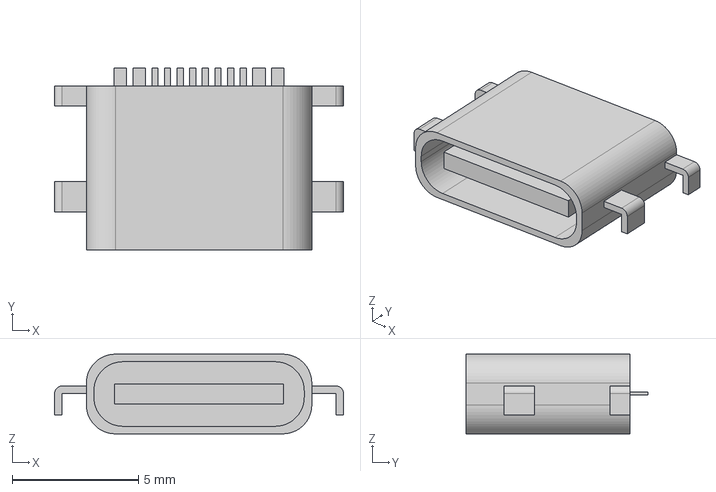
[picture p61: CAD file, 2023-08-23]
Ariamelon-Connector-3D/HRO_TYPE-C-31-M-13C.step
11.5 x 7.20 x 3.16 mm
