Ariamelon/Ariamelon-Kicad-Master-Library/Ariamelon-Switch-3D/SW_Alps_D2F-01F.step

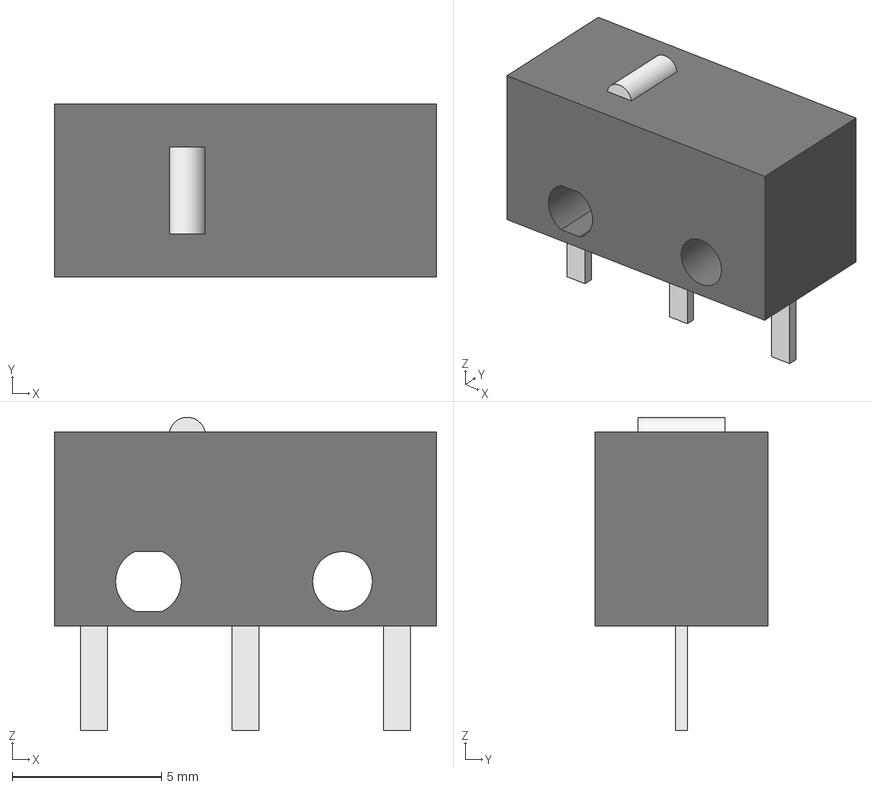
[picture p62: CAD file, 2023-08-23]
Ariamelon-Switch-3D/SW_Alps_D2F-01F.step
12.8 x 5.80 x 10.5 mm
