Ariamelon/Ariamelon-Kicad-Master-Library/Ariamelon-Connector-3D/HRO_TYPE-C-31-M-12.step

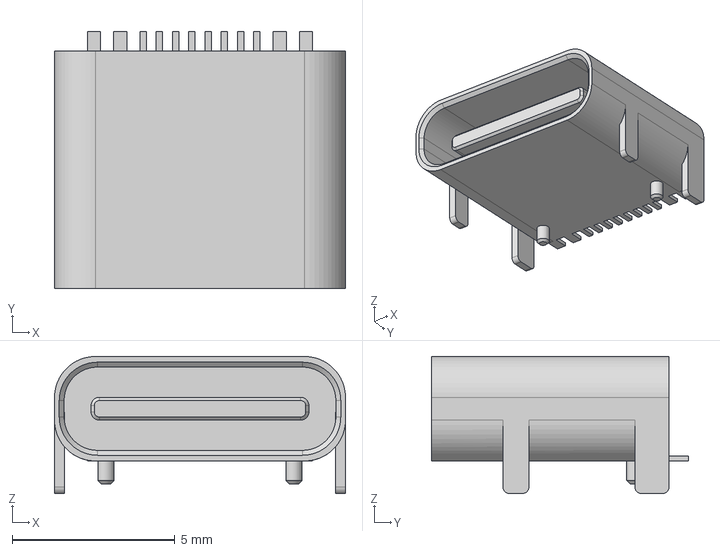
[picture p63: CAD file, 2023-08-23]
Ariamelon-Connector-3D/HRO_TYPE-C-31-M-12.step
8.94 x 7.90 x 4.21 mm
