Ariamelon/Ariamelon-Kicad-Master-Library/Ariamelon-Switch-3D/SW_Stabilizer_2U.step

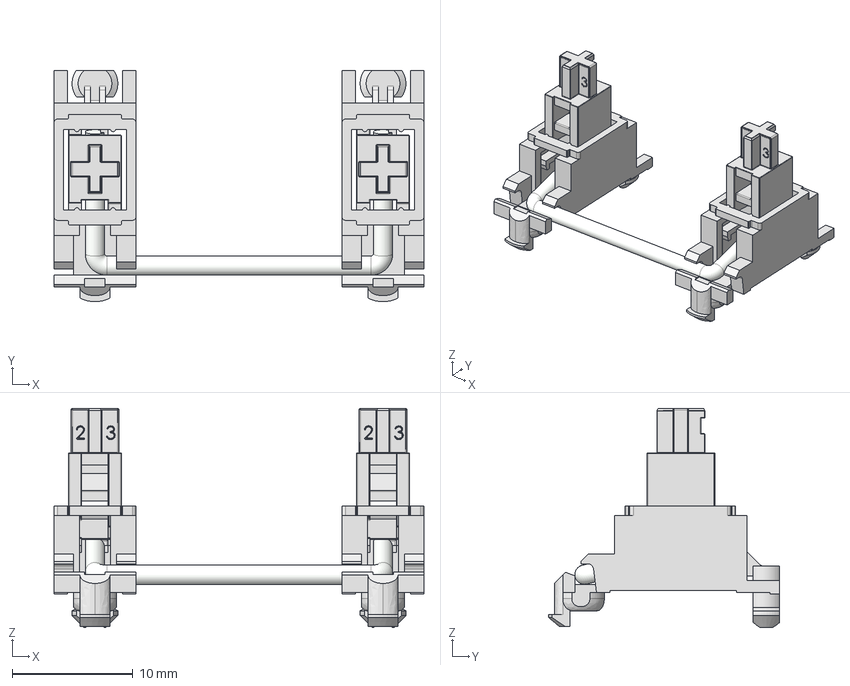
[picture p64: CAD file, 2023-08-23]
Ariamelon-Switch-3D/SW_Stabilizer_2U.step
30.7 x 19.2 x 18.2 mm
mx Stabilizer key 16828 x 2
mx Stabilizer base 16828 x 2
metal stick 16828
