Ariamelon/Ariamelon-Kicad-Master-Library/Ariamelon-Connector-3D/HRO_TYPE-C-31-M-13.STEP

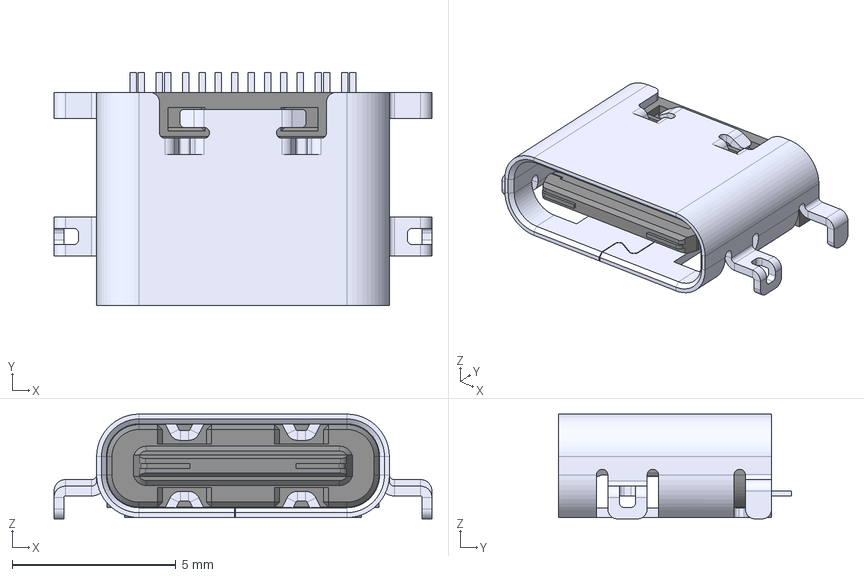
[picture p65: CAD file, 2023-08-23]
Ariamelon-Connector-3D/HRO_TYPE-C-31-M-13.STEP
11.5 x 7.10 x 3.20 mm
