Ariamelon/Ariamelon-Kicad-Master-Library/Ariamelon-Switch-3D/SW_Cap_XDA_1U.step

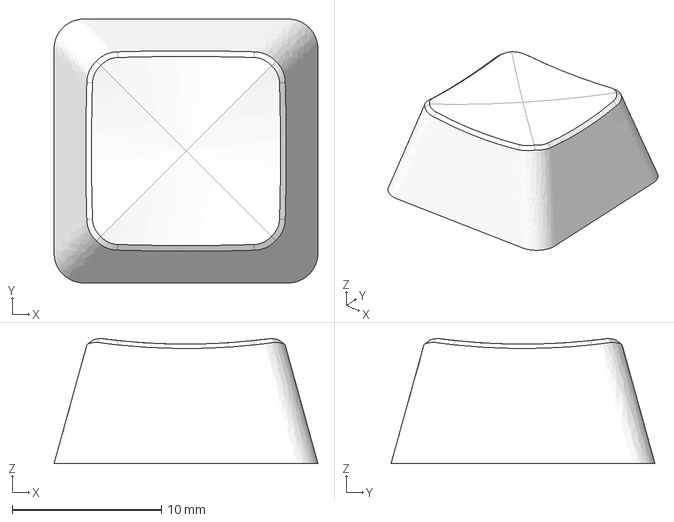
[picture p66: CAD file, 2023-08-23]
Ariamelon-Switch-3D/SW_Cap_XDA_1U.step
17.7 x 17.7 x 8.39 mm
