Ariamelon/Ariamelon-Kicad-Master-Library/Ariamelon-Switch-3D/SW_Kailh_Hotswap-Socket_Choc.step

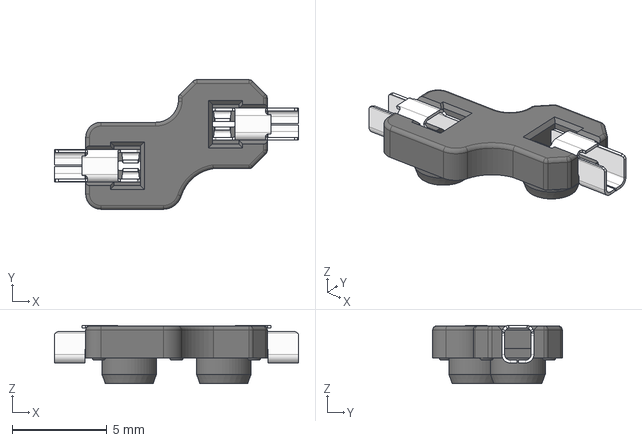
[picture p67: CAD file, 2023-08-23]
Ariamelon-Switch-3D/SW_Kailh_Hotswap-Socket_Choc.step
12.9 x 6.85 x 3.09 mm
socket
pin x 2
