Ariamelon/Ariamelon-Kicad-Master-Library/(list of files, cad)

Other CAD files:
Ariamelon-Package-3D/Texas_S-PVSON-N8-1EP_4x4mm_P0.8_EP2.5x3.4mm.stp
