Ariamelon/Ariamelon-Kicad-Master-Library/(commit log)

2023-08-24 Fixed some library links
    [RotaryEncoder_Alps_EC11E_Vertical_H20mm.step]
2023-08-26 Added new flippable footprints, edited others
    [SW_Cap_Choc_LP_1U.step]
2023-08-27 Fixed encoder library. Fixed switch footprints.
2023-09-18 Added new parts. Fixed footprints.
    [Fuse_1812_4532Metric.STEP, L_Murata_786J.STEP]
2023-09-22 Added parts
    [Heatsink_Fischer_SK104-STC-STIC_35x13mm_2xDrill2.5mm.step]
2023-09-23 New parts
    [Heatsink_CUI_HSE-B20380-040H.step]
2023-10-19 Added new parts
    [Texas_S-PVSON-N8-1EP_4x4mm_P0.8_EP2.5x3.4mm.step, Texas_S-PVSON-N8-1EP_4x4mm_P0.8_EP2.5x3.4mm.stp]
2024-10-16 Added KS27-related footprints. Added KS33 3D model.
    [SW_KS33_Hotswap-Socket.step]
